jeff-truck/Jan2023-Build/Pics/CPUNanoPCB Board Design.jpg

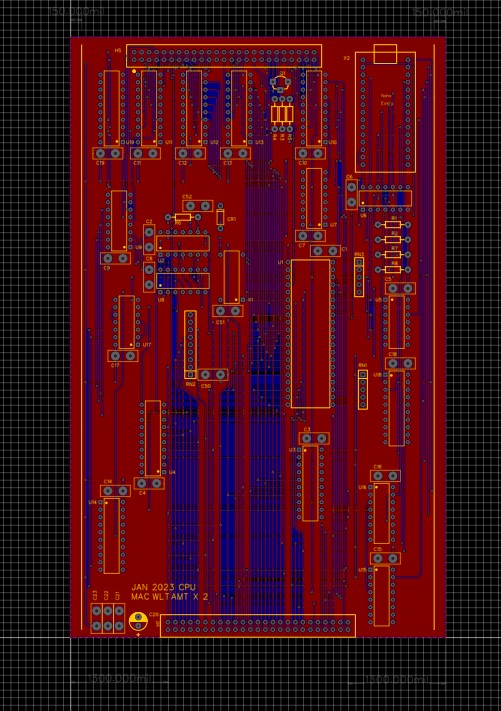
Pics/CPUNanoPCB Board Design.jpg
