jeff-truck/Jan2023-Build/Pics/BackplanePCB Board Design.jpg

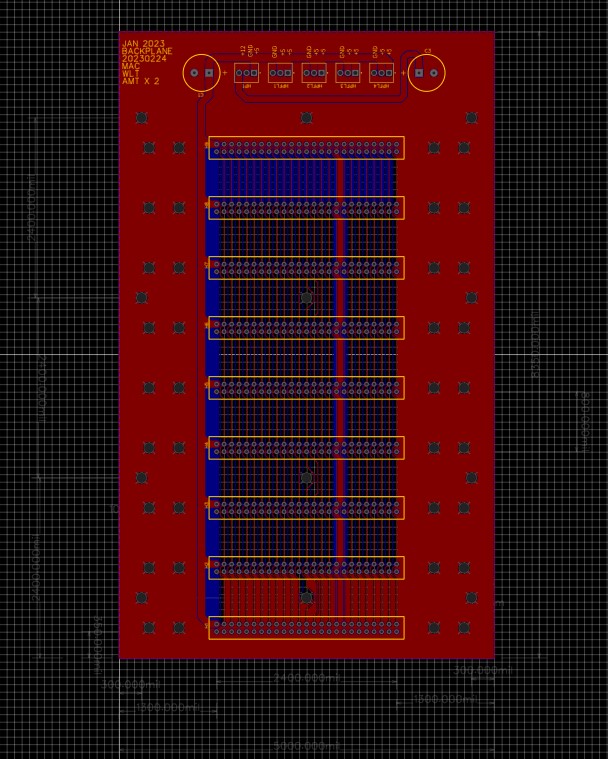
Pics/BackplanePCB Board Design.jpg
