jeff-truck/Jan2023-Build/Pics/DisplayLogicPCB Board Design.jpg

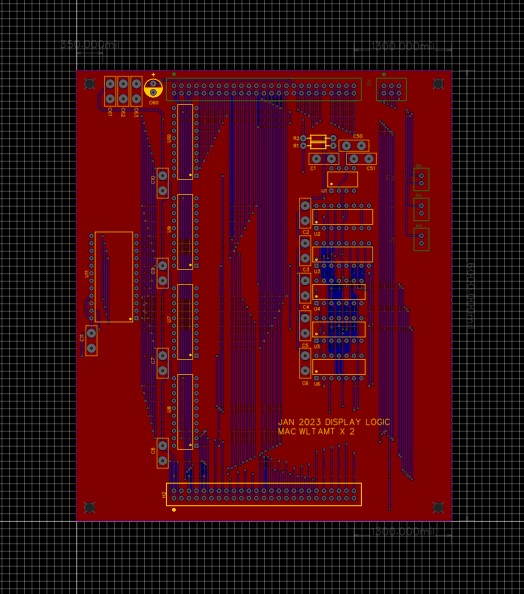
Pics/DisplayLogicPCB Board Design.jpg
