jeff-truck/Jan2023-Build/Pics/DisplayPCB Board Design.jpg

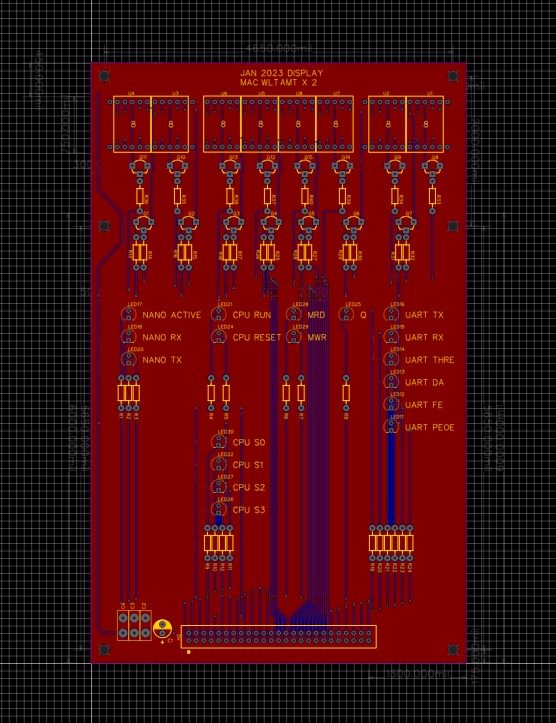
Pics/DisplayPCB Board Design.jpg
