jeff-truck/Jan2023-Build/Pics/IMG_8013.jpg

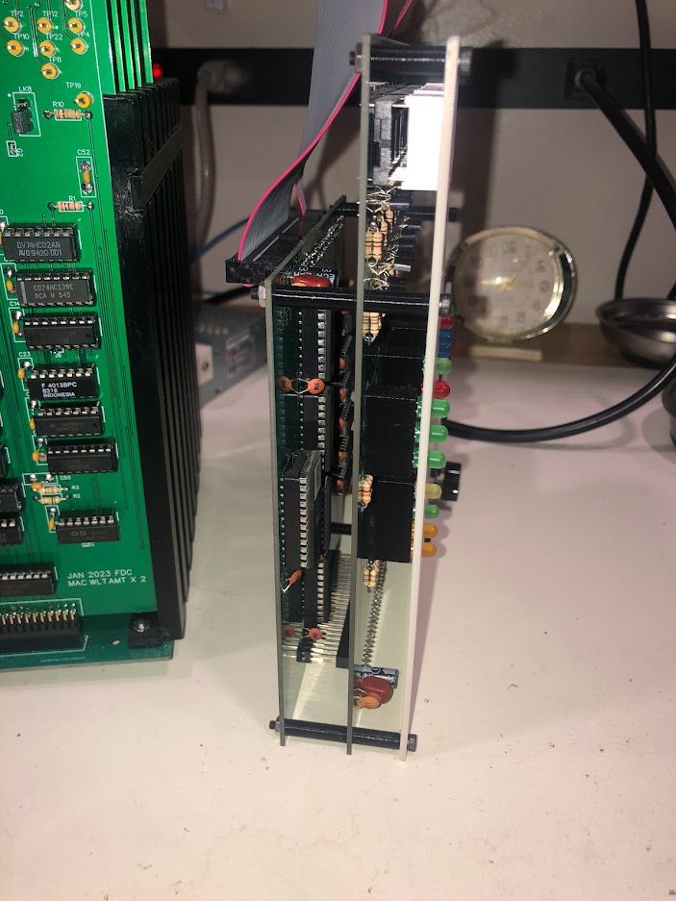
Pics/IMG_8013.jpg
