jeff-truck/Jan2023-Build/Pics/IMG_8014.jpg

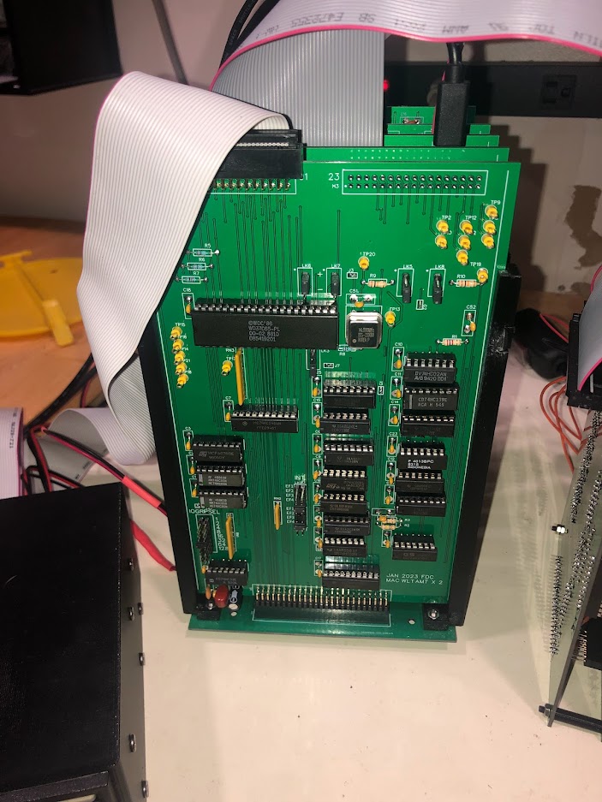
Pics/IMG_8014.jpg
