jeff-truck/Jan2023-Build/Pics/IMG_8015.jpg

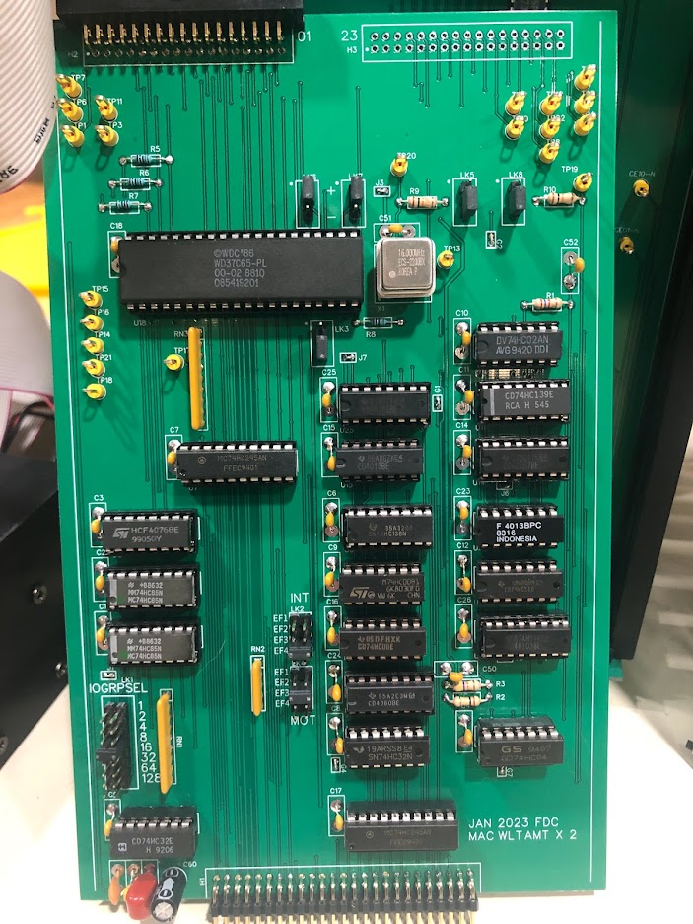
Pics/IMG_8015.jpg
