jeff-truck/Jan2023-Build/Pics/IMG_8016.jpg

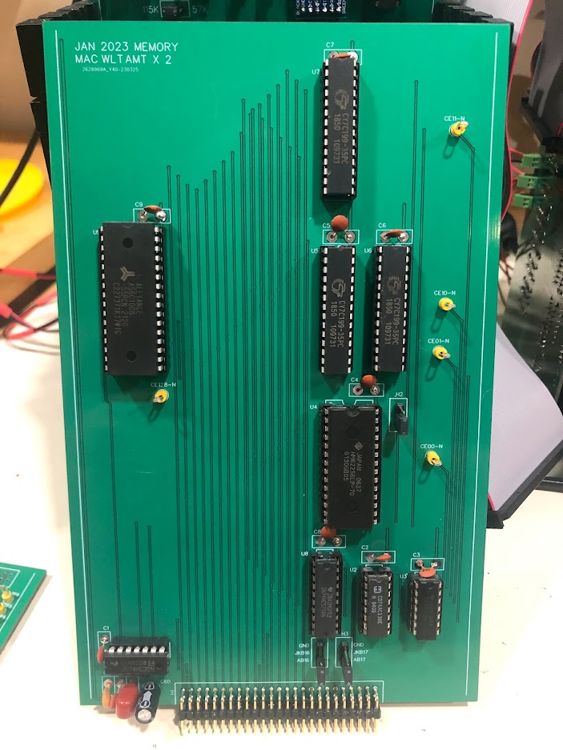
Pics/IMG_8016.jpg
