jeff-truck/Jan2023-Build/Pics/IMG_8017.jpg

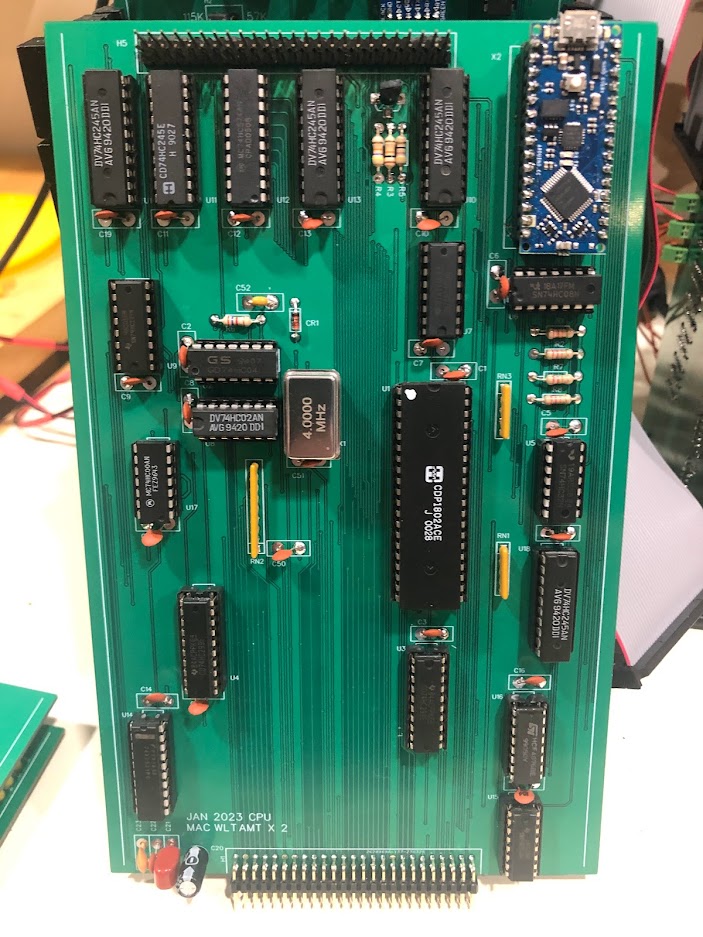
Pics/IMG_8017.jpg
