jeff-truck/Jan2023-Build/Pics/IMG_8018.jpg

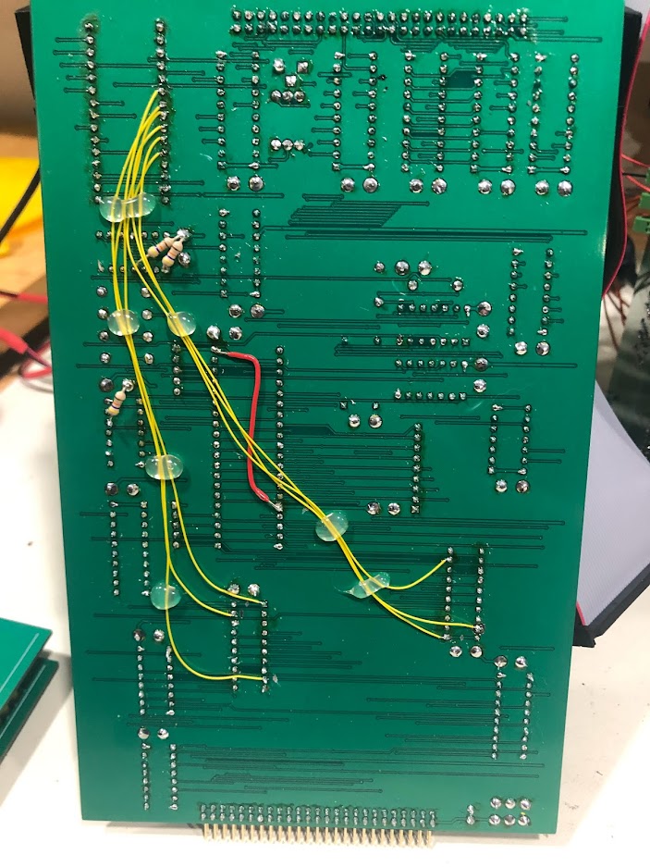
Pics/IMG_8018.jpg
