jeff-truck/Jan2023-Build/Pics/IMG_8019.jpg

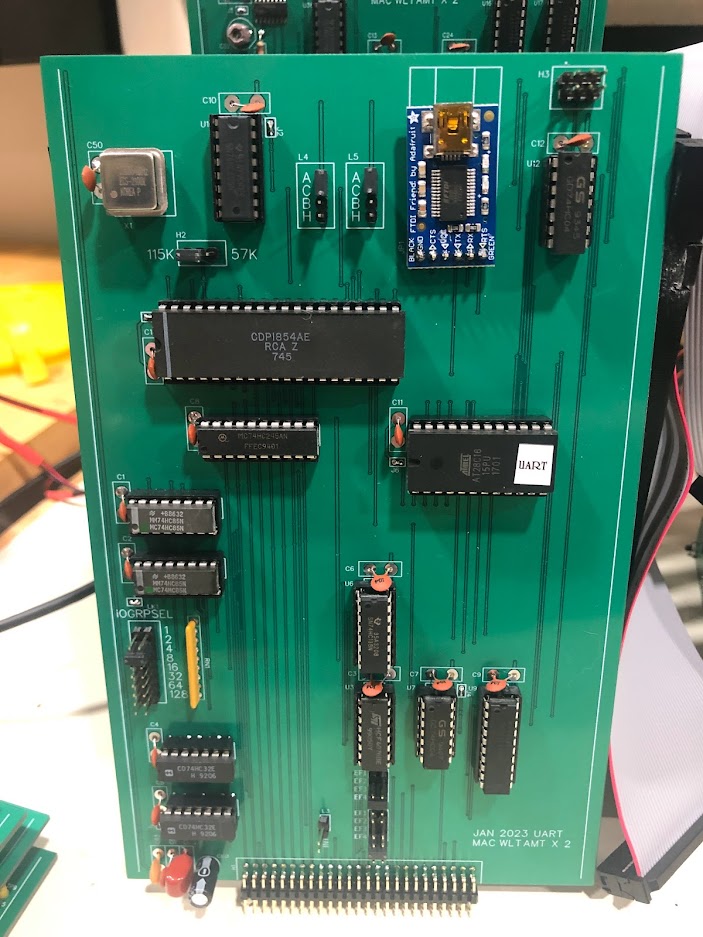
Pics/IMG_8019.jpg
