jeff-truck/Jan2023-Build/Pics/IMG_8020.jpg

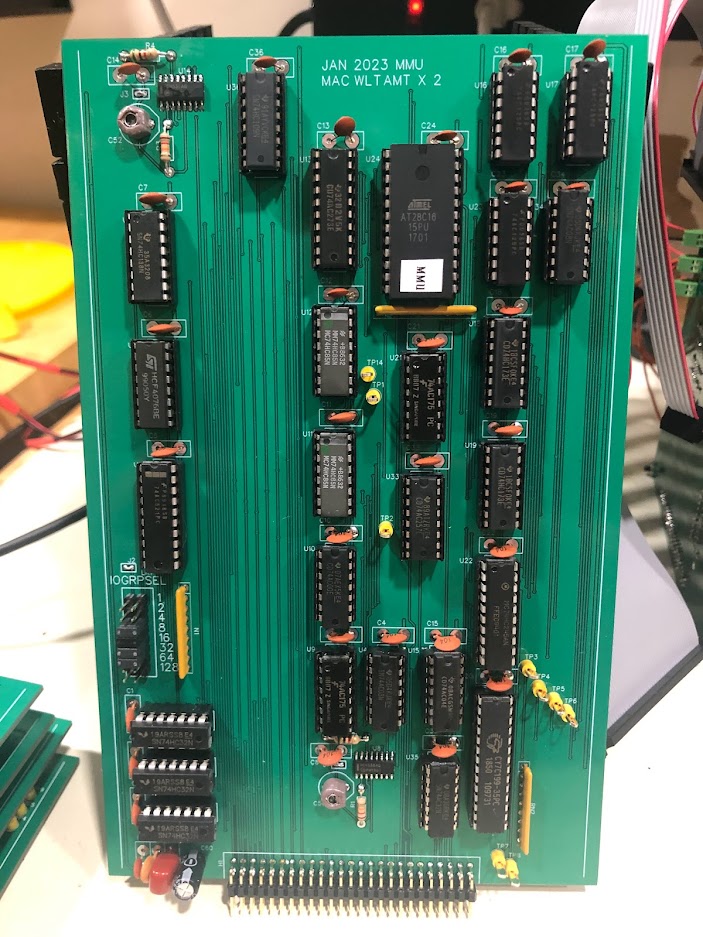
Pics/IMG_8020.jpg
