jeff-truck/Jan2023-Build/Pics/IMG_8021.jpg

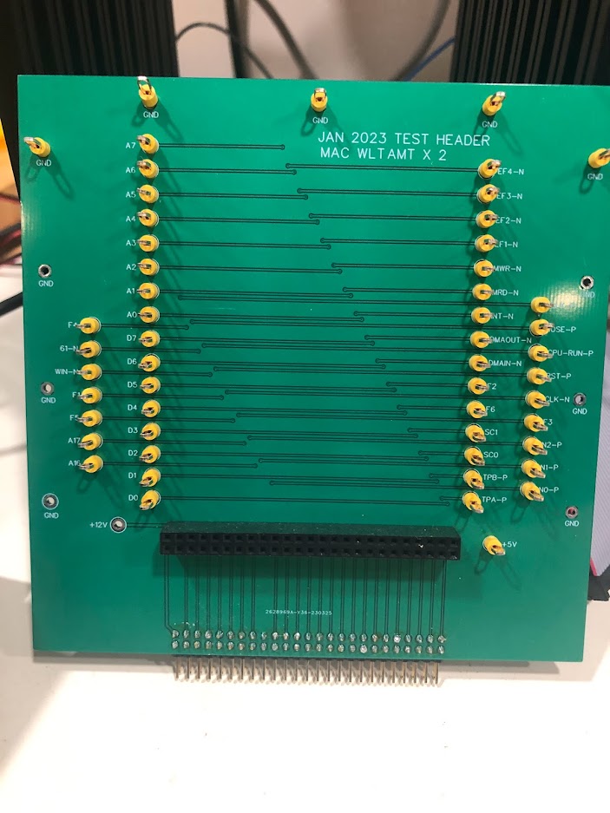
Pics/IMG_8021.jpg
