jeff-truck/Jan2023-Build/Pics/IMG_8023.jpg

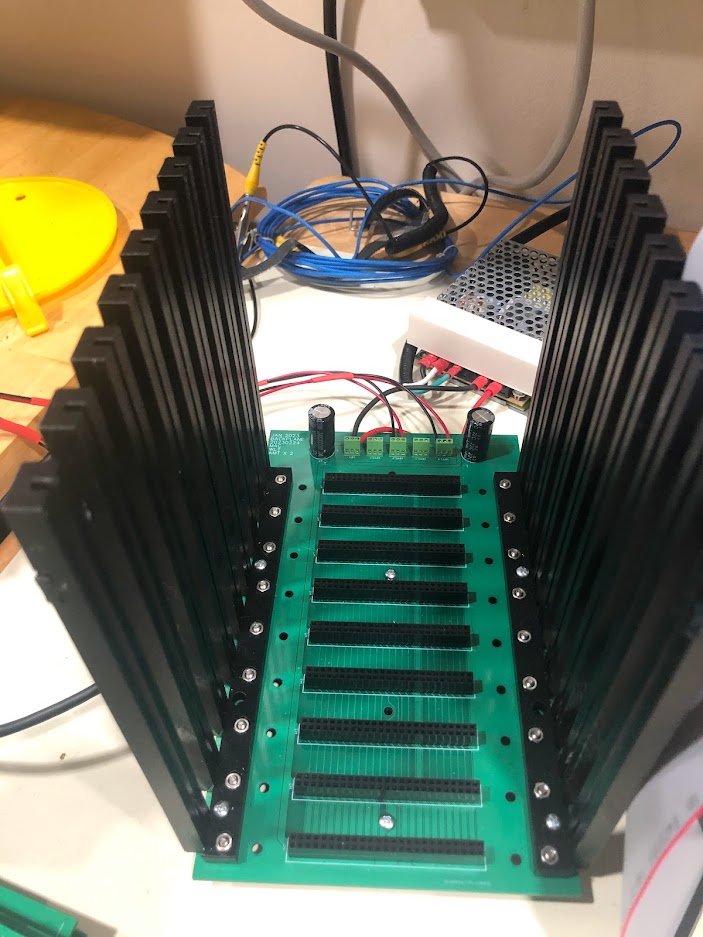
Pics/IMG_8023.jpg
