jeff-truck/Jan2023-Build/Pics/IMG_8024.jpg

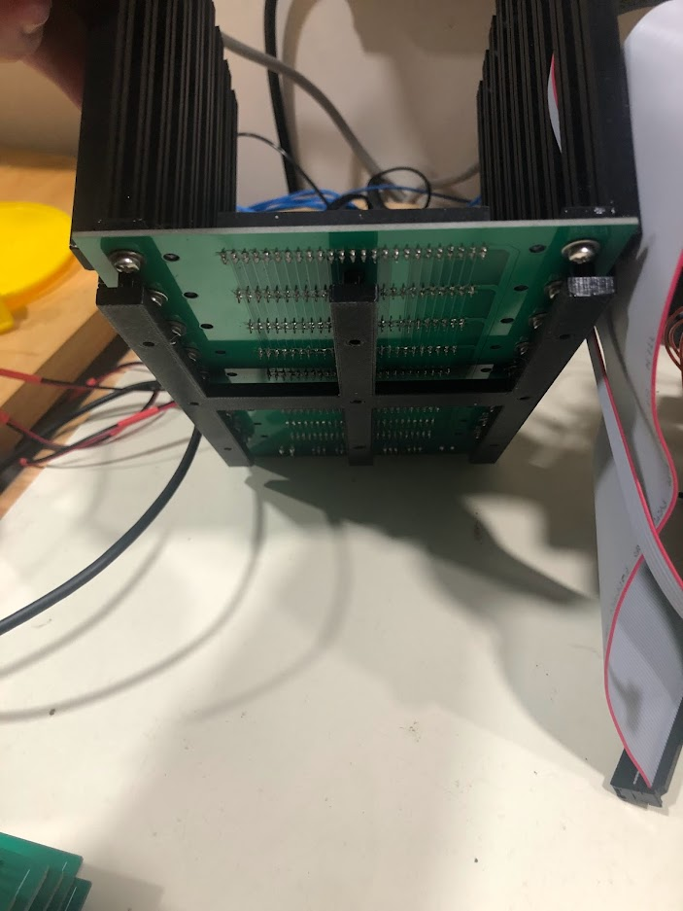
Pics/IMG_8024.jpg
