jeff-truck/Jan2023-Build/Pics/IMG_8026.jpg

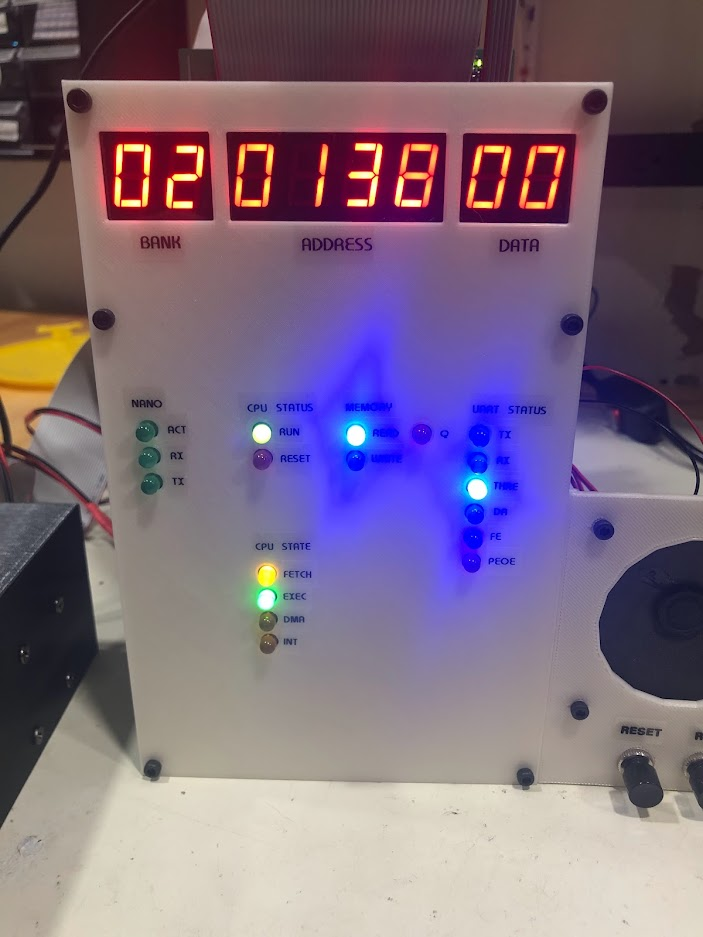
Pics/IMG_8026.jpg
