jeff-truck/Jan2023-Build/Pics/IMG_8030.jpg

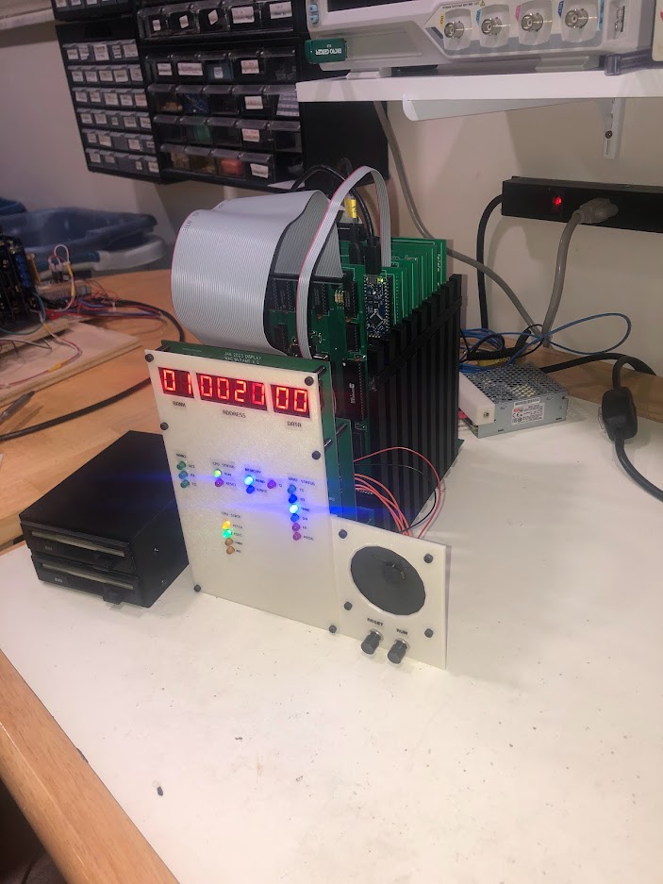
Pics/IMG_8030.jpg
