jeff-truck/Jan2023-Build/Pics/MemoryManagerPCB Board Design.jpg

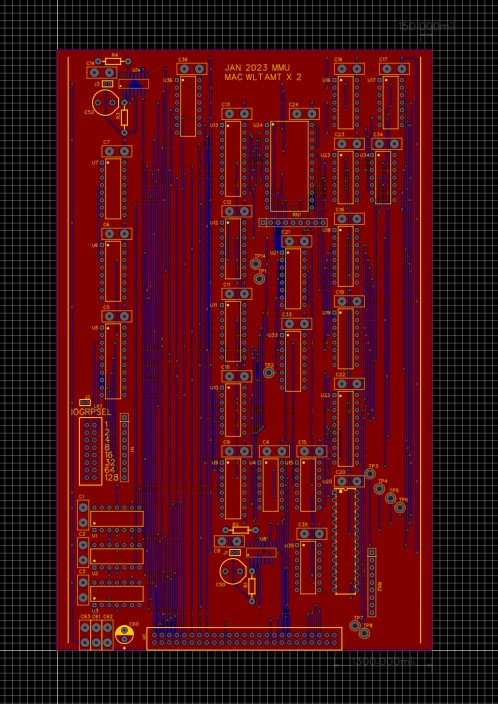
Pics/MemoryManagerPCB Board Design.jpg
