jeff-truck/Jan2023-Build/Pics/MemoryPCB Board Design.jpg

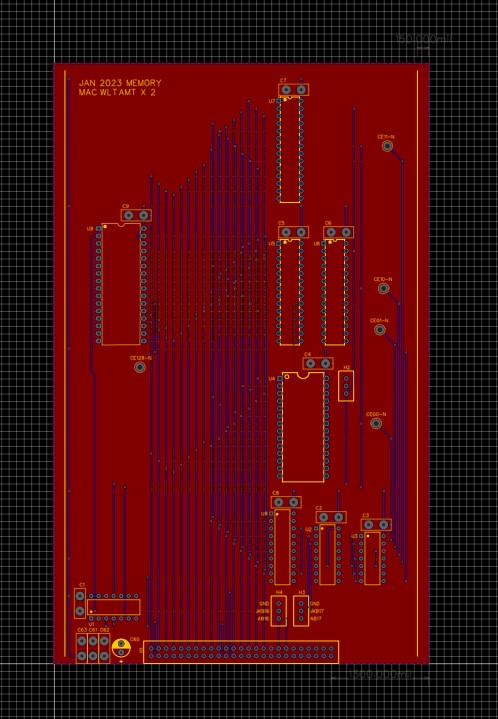
Pics/MemoryPCB Board Design.jpg
