jeff-truck/Jan2023-Build/BOMs/BOM_2023 JAN DISPLAY BOARD_2023-03-24.csv

ID | Name | Designator | Footprint | Quantity
1 | 100uF | C1 | CAP ELEC BOW 3MM LP | 1
2 | CAP 1.0uF LP | C2 | CAP RAD-0.2 LRG PAD | 1
3 | CAP 0.1uF LP | C3 | CAP RAD-0.2 LRG PAD | 1
4 | CAP 0.01uF LP | C4 | CAP RAD-0.2 LRG PAD | 1
5 | 2x25 50P HDR | H2 | 2X25 50P HDR | 1
6 | LED-5MM-RED | LED11,LED12,LED24,LED25 | 5MM LED | 4
7 | LED-5MM-GRN | LED13,LED16,LED17,LED18,LED20,LED21,LED22 | 5MM LED | 7
8 | LED-5MM-BLU | LED14,LED15,LED28,LED29 | 5MM LED | 4
9 | LED-5MM-ORG | LED26,LED27 | 5MM LED | 2
10 | LED-5MM-YLW | LED30 | 5MM LED | 1
11 | 2N2222 JAN 2023 LP | Q1,Q2,Q3,Q4,Q5,Q6,Q7,Q8,Q9,Q10,Q11,Q12,Q13,Q14,Q15 | TO92 LP | 15
12 | 220 RES 0.4 LP | R1,R2,R3,R4,R10,R19,R22 | AXIAL-0.4 LRG PAD | 7
13 | 560 RES 0.4 LP | R5,R8,R23,R24 | AXIAL-0.4 LRG PAD | 4
14 | 680 RES 0.4 LP | R6,R7,R20,R21 | AXIAL-0.4 LRG PAD | 4
15 | 470 RES 0.4 LP | R9,R11,R12 | AXIAL-0.4 LRG PAD | 3
16 | 180 RES 0.4 LP | R13,R16,R18,R26,R28,R29,R31 | AXIAL-0.4 LRG PAD | 7
17 | 1K RES 0.4 LP | R14,R15,R17,R25,R27,R30,R32,R33,R34,R35,R36,R37,R38,R39,R40 | AXIAL-0.4 LRG PAD | 15
18 | 7 SEG CC | U1,U3 | 7 SEG CC 2.54 12.5X15.24 XTRA RIGHT | 2
19 | 7 SEG CC | U2,U4 | 7 SEG CC 2.54 12.5X15.24 XTRA LEFT | 2
20 | 7 SEG CC | U5,U6,U7,U8 | 7 SEG CC 2.54 12.5X15.24 | 4
