jeff-truck/Jan2023-Build/BOMs/BOM_2023 JAN DISPLAY LOGIC_2023-03-24.csv

ID | Name | Designator | Footprint | Quantity
1 | CAP 0.1uF LP | C1,C2,C3,C4,C5,C6,C7,C8,C9,C10,C11,C62 | CAP RAD-0.2 LRG PAD | 12
2 | CAP 0.01uF LP | C50,C51,C63 | CAP RAD-0.2 LRG PAD | 3
3 | 100uF | C60 | CAP ELEC BOW 3MM LP | 1
4 | CAP 1.0uF LP | C61 | CAP RAD-0.2 LRG PAD | 1
5 | 2X25 LINEAR HDR | H1 | 2X25 50P HDR | 1
6 | 2x25 50P HDR | H2 | 2X25 50P HDR | 1
7 | 6 PIN 2X3 HDR | H3 | 2X3 2.54 HDR | 1
8 | 2 PIN GENERAL HDR | H4,H5,H6 | 2 PIN SYSIO HDR | 3
9 | 100K RES 0.4 LP | R1 | AXIAL-0.4 LRG PAD | 1
10 | 1K RES 0.4 LP | R2 | AXIAL-0.4 LRG PAD | 1
11 | 555 | U1 | DIP8 | 1
12 | CD74HCT161 | U2 | DIP16 | 1
13 | CD74HC137 | U3 | DIP16 | 1
14 | CD74HC574 | U7,U8,U9,U10 | DIP20 | 4
15 | AT28C16 | U11 | DIP24-600 | 1
16 | 74HC04 2023 JAN | U4,U5 | DIP14 | 2
17 | 74HC08 JAN 2023 | U6 | DIP14 | 1
