jeff-truck/Jan2023-Build/BOMs/BOM_2023 JAN FDC_2023-05-28.csv

ID | Name | Designator | Footprint | Quantity
1 | CAP 0.1uF LP | C1,C2,C3,C4,C5,C6,C7,C8,C9,C10,C11,C12,C14,C15,C16,C17,C18,C23,C24,C25,C26,C51,C52,C62 | CAP RAD-0.2 LRG PAD | 24
2 | CAP 4700pF LP | C50 | CAP RAD-0.2 LRG PAD | 1
3 | 100uF | C60 | CAP ELEC BOW 3MM LP | 1
4 | CAP 1.0uF LP | C61 | CAP RAD-0.2 LRG PAD | 1
5 | CAP 0.01uF LP | C63 | CAP RAD-0.2 LRG PAD | 1
6 | GNDJMP | G1,G2,G4,G7 | GNDJMP | 4
7 | BRD HEADER 2X25 2023 JAN | H1 | BRD HEADER 2X25 0.100 | 1
8 | FLOPPY HEADER 34PIN | H2,H3 | FLOPPY HEADER 34 PIN | 2
9 | POSJMP | J1,J2,J3,J6,J7 | POSJMP | 5
10 | IO GRP SEL HDR | LK1 | IO GRP SEL HDR | 1
11 | EFx INT-N | LK2 | EFX SELECT LINK | 1
12 | MOTOR FLIP FLOP SOURCE | LK3 | 3 PIN PTH HEADER | 1
13 | EFx MOTOR-ON-N | LK4 | EFX SELECT LINK | 1
14 | IRQ PU PD | LK5 | 3 PIN PTH HEADER | 1
15 | PCVAL SELECT | LK6 | 3 PIN PTH HEADER | 1
16 | DRV SELECT | LK7 | 3 PIN PTH HEADER | 1
17 | DMA PU PD | LK8 | 3 PIN PTH HEADER | 1
18 | 2.7K | R1 | R_AXIAL-0.4 | 1
19 | 100K | R2 | R_AXIAL-0.4 | 1
20 | 47K | R3 | R_AXIAL-0.4 | 1
21 | 150 | R5,R6,R7,R8 | R_AXIAL-0.4 | 4
22 | 10K | R9,R10 | R_AXIAL-0.4 | 2
23 | R_NET_8_10K | RN1,RN3 | R_ARRAY_SIP9 | 2
24 | 4605X 47K 2023 JAN | RN2 | DIP-1X5P-2.54 2023 JAN | 1
25 | 5014 TP | TP1,TP2,TP3,TP4,TP5,TP6,TP7,TP8,TP9,TP10,TP11,TP12,TP13,TP14,TP15,TP16,TP17,TP18,TP19,TP20,TP21,TP22 | 5014 TEST POINT | 22
26 | 74HC85 IO | U1,U2 | DIP16 | 2
27 | 4076 IO | U3 | DIP16 | 1
28 | 74HC138 | U6 | DIP16 | 1
29 | 74HC245 | U7,U17 | DIP20 | 2
30 | 40257 JAN 2023 | U14 | DIP16 | 1
31 | WDC37C65C | U18 | DIP40 | 1
32 | 4060 JAN 2023 | U24 | DIP16 | 1
33 | 40103 | U25,U26 | DIP16 | 2
34 | 16MHZ HC CLK | X1 | HC CLK DIP 8 | 1
35 | 74HC04 2023 JAN | U4 | DIP14 | 1
36 | CD74HC32 JAN 2023 | U5,U8 | DIP14 | 2
37 | 74HC00 JAN 2023 | U9,U16 | DIP14 | 2
38 | 74HC02 JAN 2023 | U10 | DIP14 | 1
39 | 74HC139 JAN 2023 | U11 | DIP16 | 1
40 | 74HC11 JAN 2023 | U12 | DIP14 | 1
41 | 4013 JAN 2023 | U15,U23 | DIP14 | 2
