jeff-truck/Jan2023-Build/BOMs/BOM_2023 JAN MEMORY_2023-03-24.csv

ID | Name | Designator | Footprint | Quantity
1 | CAP 0.1uF LP | C1,C2,C3,C4,C5,C6,C7,C8,C9,C62 | CAP RAD-0.2 LRG PAD | 10
2 | 100uF | C60 | CAP ELEC BOW 3MM LP | 1
3 | CAP 1.0uF LP | C61 | CAP RAD-0.2 LRG PAD | 1
4 | CAP 0.01uF LP | C63 | CAP RAD-0.2 LRG PAD | 1
5 | BRD HEADER 2X25 2023 JAN | H1 | BRD HEADER 2X25 0.100 | 1
6 | 3 PIN PTH HEADER | H2,H3,H4 | 3 PIN PTH HEADER | 3
7 | 5014 TP | TP9,TP10,TP11,TP12,TP13 | 5014 TEST POINT | 5
8 | 74HC32 FULL | U1 | DIP14 | 1
9 | 74AC138 IO | U2 | DIP16 | 1
10 | 74AC08 FULL | U3 | DIP14 | 1
11 | AT28C256 | U4 | PDIP-28_600MIL | 1
12 | CY7C199-35PC | U5,U6,U7 | DIP-28_L35.0-W6.5-P2.54-LS7.6-BL | 3
13 | 74HC573 | U8 | DIP20 | 1
14 | 128K_X_8_RAM | U9 | DIP32_600 | 1
