jeff-truck/Jan2023-Build/BOMs/BOM_2023 JAN UART_2023-03-24.csv

ID | Name | Designator | Footprint | Quantity
1 | CAP 0.1uF LP | C1,C2,C3,C4,C5,C6,C7,C8,C9,C10,C11,C12,C14,C50,C62 | CAP RAD-0.2 LRG PAD | 15
2 | 100uF | C60 | CAP ELEC BOW 3MM LP | 1
3 | CAP 1.0uF LP | C61 | CAP RAD-0.2 LRG PAD | 1
4 | CAP 0.01uF LP | C63 | CAP RAD-0.2 LRG PAD | 1
5 | BRD HEADER 2X25 2023 JAN | H1 | BRD HEADER 2X25 0.100 | 1
6 | 3 PIN GENERAL HDR | H2 | 3 PIN SYSIO HDR | 1
7 | 6 PIN 2X3 HDR | H3 | 2X3 2.54 HDR | 1
8 | POSJMP | J1,J2,J3,J4,J5,J6 | POSJMP | 6
9 | FTDI_DEVICE | JP1 | FTDI FRIEND | 1
10 | EFx Select Link | L1,L2 | EFX SELECT LINK | 2
11 | INT Enable Link | L3 | INT SELECT LINK | 1
12 | UART EXT ES LINK | L4 | UART EXT ES | 1
13 | UART EXT PSI LINK | L5 | UART EXT ES | 1
14 | IO GRP SEL HDR | LK1 | IO GRP SEL HDR | 1
15 | R_NET_8_10K | RN1 | R_ARRAY_SIP9 | 1
16 | 74HC85 IO | U1,U2 | DIP16 | 2
17 | 4076 IO | U3 | DIP16 | 1
18 | 74HC138 | U6 | DIP16 | 1
19 | 74HC245 | U8,U9 | DIP20 | 2
20 | AT28C16 IO | U11 | DIP24-600 | 1
21 | CDP 1854 | U14 | CDP 1854 | 1
22 | ECS-2100X 3.6864MHz | X1 | ECS-2100X 3.6864MHZ | 1
23 | CD74HC32 JAN 2023 | U4,U5 | DIP14 | 2
24 | 74HC04 2023 JAN | U7,U12 | DIP14 | 2
25 | 74HC109 JAN 2023 | U10 | DIP16 | 1
