jeff-truck/Jan2023-Build/BOMs/BOM_2023 JAN CPU V1_2023-03-24.csv

ID | Name | Designator | Footprint | Quantity
1 | CAP 0.1uF LP | C1,C2,C3,C4,C5,C6,C7,C8,C9,C10,C11,C12,C13,C14,C15,C16,C17,C18,C19,C22,C50,C51 | CAP RAD-0.2 LRG PAD | 22
2 | 100uF | C20 | CAP ELEC BOW 3MM LP | 1
3 | CAP 1.0uF LP | C21 | CAP RAD-0.2 LRG PAD | 1
4 | CAP 0.01uF LP | C23 | CAP RAD-0.2 LRG PAD | 1
5 | CAP 47pF LP | C52 | CAP RAD-0.2 LRG PAD | 1
6 | 1N914 | CR1 | DO-35 | 1
7 | BRD HEADER 2X25 2023 JAN | H1 | BRD HEADER 2X25 0.100 | 1
8 | 2X25 LINEAR HDR | H5 | 2X25 50P HDR | 1
9 | 2N2222 JAN 2023 LP | Q1 | TO92 LP | 1
10 | 22K RES 0.4 LP | R1,R2,R7,R8 | AXIAL-0.4 LRG PAD | 4
11 | 10K RES 0.4 LP | R3 | AXIAL-0.4 LRG PAD | 1
12 | 47K RES 0.4 LP | R4 | AXIAL-0.4 LRG PAD | 1
13 | 100 RES 0.4 LP | R5 | AXIAL-0.4 LRG PAD | 1
14 | 2.7K RES 0.4 LP | R6 | AXIAL-0.4 LRG PAD | 1
15 | 4605X 47K 2023 JAN | RN1,RN3 | DIP-1X5P-2.54 2023 JAN | 2
16 | 4609X 22K 2023 JAN | RN2 | DIP-1X9P-2.54 2023 JAN | 1
17 | CDP 1802 2023 JAN | U1 | CDP 1802 | 1
18 | 74HC299 IO | U3,U4 | DIP20 | 2
19 | 74HC245 | U10,U11,U13,U18,U19 | DIP20 | 5
20 | CD74HC574 | U12 | DIP20 | 1
21 | 74AC521 IO | U14 | DIP20 | 1
22 | CD74HC138E | U15 | DIP16 | 1
23 | 4076 | U16 | DIP16 | 1
24 | 4MHZ CMOS CLK CAN | X1 | 4MHZ CMOS CLK CAN | 1
25 | NANO EVERY JAN 2023 | X2 | NANOEVERY JAN 2023 | 1
26 | 74HC04 2023 JAN | U2 | DIP14 | 1
27 | CD74HC32 JAN 2023 | U5 | DIP14 | 1
28 | 74HC08 JAN 2023 | U6 | DIP14 | 1
29 | 74HC109 JAN 2023 | U7 | DIP16 | 1
30 | 74HC02 JAN 2023 | U8 | DIP14 | 1
31 | 74HC139 JAN 2023 | U9 | DIP16 | 1
32 | 74HC00 JAN 2023 | U17 | DIP14 | 1
