jeff-truck/Jan2023-Build/BOMs/BOM_2023 JAN MMU_2023-03-24.csv

ID | Name | Designator | Footprint | Quantity
1 | CAP 0.1uF LP | C1,C2,C3,C4,C5,C6,C7,C8,C9,C10,C11,C12,C13,C14,C15,C16,C17,C18,C19,C20,C21,C22,C23,C24,C33,C34,C35,C36,C62 | CAP RAD-0.2 LRG PAD | 29
2 | CAP-ADJ 12-60PF | C50,C52 | GKGXX015 | 2
3 | 100uF | C60 | CAP ELEC BOW 3MM LP | 1
4 | CAP 1.0uF LP | C61 | CAP RAD-0.2 LRG PAD | 1
5 | CAP 0.01uF LP | C63 | CAP RAD-0.2 LRG PAD | 1
6 | BRD HEADER 2X25 2023 JAN | H1 | BRD HEADER 2X25 0.100 | 1
7 | POSJMP | J1,J2,J3 | POSJMP | 3
8 | IO GRP SEL HDR | LK1 | IO GRP SEL HDR | 1
9 | 8 PIN 10K | N1 | R_ARRAY_SIP9 | 1
10 | 12K RES 0.4 LP | R1,R3 | AXIAL-0.4 LRG PAD | 2
11 | 5.1K RES 0.4 LP | R2,R4 | AXIAL-0.4 LRG PAD | 2
12 | R_NET_8_10K | RN1 | R_ARRAY_SIP9 | 1
13 | R_NET_8_22K | RN2 | R_ARRAY_SIP9 | 1
14 | 5014 TP | TP1,TP2,TP3,TP4,TP5,TP6,TP7,TP8,TP14 | 5014 TEST POINT | 9
15 | 74HC32 FULL | U1,U2,U3 | DIP14 | 3
16 | 74AC521 IO | U5 | DIP20 | 1
17 | 4076 | U6 | DIP16 | 1
18 | CD74HC138E | U7 | DIP16 | 1
19 | 74HC4538ADR | U8,U14 | SOIC-16_L9.9-W3.9-P1.27-LS6.0-BL | 2
20 | 74AC175 IO | U9,U21 | DIP16 | 2
21 | 74HC85 IO | U11,U12 | DIP16 | 2
22 | 74AC273 IO | U13 | DIP20 | 1
23 | 74AC125 IO | U16,U17,U23 | DIP14 | 3
24 | 74HC173 IO | U18,U19 | DIP16 | 2
25 | CY7C199-35PC | U20 | DIP-28_L35.0-W6.5-P2.54-LS7.6-BL | 1
26 | 74HC245 | U22 | DIP20 | 1
27 | AT28C16 IO | U24 | DIP24-600 | 1
28 | CD74AC257 IO | U33 | DIP16 | 1
29 | 74AC08 JAN 2023 | U4,U34 | DIP14 | 2
30 | 74AC00 JAN 2023 | U10 | DIP14 | 1
31 | 74AC04 | U15 | DIP14 | 1
32 | 74AC32 JAN 2023 | U35 | DIP14 | 1
33 | 74HC109 JAN 2023 | U36 | DIP16 | 1
