jeff-truck/Jan2023-Build/Microcode/1802 Instruction Set Microcode 20221230.xlsx

 |  |  |  |  |  |  |  |  |  | FETCHED INSTRUCTION |  |  |  |  |  |  |  | INDEX |  |  |  | N | X | P
FAMILY | GROUP | MNEMONIC | OP CODE | OPERATION | I | N | X BASED | MEM ACC | REG BANK | A0 | A1 | A2 | A3 | A4 | A5 | A6 | A7 | D0 | D1 | D2 | D3 | D4 | D5 | D6
MEMORY REFERENCE | 3: R/R | LDN | 01 | M(R(N)) → D; FOR N not 0 | 0 | 1 | N | Y | 1 | 1 | 0 | 0 | 0 | 0 | 0 | 0 | 0 | 1 | 0 | 0 | 0 | 0 | 1 | 1 | 1 => '61',
MEMORY REFERENCE | 3: R/R | LDN | 02 | M(R(N)) → D; FOR N not 0 | 0 | 2 | N | Y | 2 | 0 | 1 | 0 | 0 | 0 | 0 | 0 | 0 | 0 | 1 | 0 | 0 | 0 | 1 | 1 | 2 => '62',
MEMORY REFERENCE | 3: R/R | LDN | 03 | M(R(N)) → D; FOR N not 0 | 0 | 3 | N | Y | 3 | 1 | 1 | 0 | 0 | 0 | 0 | 0 | 0 | 1 | 1 | 0 | 0 | 0 | 1 | 1 | 3 => '63',
MEMORY REFERENCE | 3: R/R | LDN | 04 | M(R(N)) → D; FOR N not 0 | 0 | 4 | N | Y | 4 | 0 | 0 | 1 | 0 | 0 | 0 | 0 | 0 | 0 | 0 | 1 | 0 | 0 | 1 | 1 | 4 => '64',
MEMORY REFERENCE | 3: R/R | LDN | 05 | M(R(N)) → D; FOR N not 0 | 0 | 5 | N | Y | 5 | 1 | 0 | 1 | 0 | 0 | 0 | 0 | 0 | 1 | 0 | 1 | 0 | 0 | 1 | 1 | 5 => '65',
MEMORY REFERENCE | 3: R/R | LDN | 06 | M(R(N)) → D; FOR N not 0 | 0 | 6 | N | Y | 6 | 0 | 1 | 1 | 0 | 0 | 0 | 0 | 0 | 0 | 1 | 1 | 0 | 0 | 1 | 1 | 6 => '66',
MEMORY REFERENCE | 3: R/R | LDN | 07 | M(R(N)) → D; FOR N not 0 | 0 | 7 | N | Y | 7 | 1 | 1 | 1 | 0 | 0 | 0 | 0 | 0 | 1 | 1 | 1 | 0 | 0 | 1 | 1 | 7 => '67',
MEMORY REFERENCE | 3: R/R | LDN | 08 | M(R(N)) → D; FOR N not 0 | 0 | 8 | N | Y | 8 | 0 | 0 | 0 | 1 | 0 | 0 | 0 | 0 | 0 | 0 | 0 | 1 | 0 | 1 | 1 | 8 => '68',
MEMORY REFERENCE | 3: R/R | LDN | 09 | M(R(N)) → D; FOR N not 0 | 0 | 9 | N | Y | 9 | 1 | 0 | 0 | 1 | 0 | 0 | 0 | 0 | 1 | 0 | 0 | 1 | 0 | 1 | 1 | 9 => '69',
MEMORY REFERENCE | 3: R/R | LDN | 0A | M(R(N)) → D; FOR N not 0 | 0 | A | N | Y | A | 0 | 1 | 0 | 1 | 0 | 0 | 0 | 0 | 0 | 1 | 0 | 1 | 0 | 1 | 1 | 10 => '6A',
MEMORY REFERENCE | 3: R/R | LDN | 0B | M(R(N)) → D; FOR N not 0 | 0 | B | N | Y | B | 1 | 1 | 0 | 1 | 0 | 0 | 0 | 0 | 1 | 1 | 0 | 1 | 0 | 1 | 1 | 11 => '6B',
MEMORY REFERENCE | 3: R/R | LDN | 0C | M(R(N)) → D; FOR N not 0 | 0 | C | N | Y | C | 0 | 0 | 1 | 1 | 0 | 0 | 0 | 0 | 0 | 0 | 1 | 1 | 0 | 1 | 1 | 12 => '6C',
MEMORY REFERENCE | 3: R/R | LDN | 0D | M(R(N)) → D; FOR N not 0 | 0 | D | N | Y | D | 1 | 0 | 1 | 1 | 0 | 0 | 0 | 0 | 1 | 0 | 1 | 1 | 0 | 1 | 1 | 13 => '6D',
MEMORY REFERENCE | 3: R/R | LDN | 0E | M(R(N)) → D; FOR N not 0 | 0 | E | N | Y | E | 0 | 1 | 1 | 1 | 0 | 0 | 0 | 0 | 0 | 1 | 1 | 1 | 0 | 1 | 1 | 14 => '6E',
MEMORY REFERENCE | 3: R/R | LDN | 0F | M(R(N)) → D; FOR N not 0 | 0 | F | N | Y | F | 1 | 1 | 1 | 1 | 0 | 0 | 0 | 0 | 1 | 1 | 1 | 1 | 0 | 1 | 1 | 15 => '6F',
MEMORY REFERENCE | 3: R/R | LDA | 40 | M(R(N)) → D; R(N) + 1 → R(N) | 4 | 0 | N | Y | 0 | 0 | 0 | 0 | 0 | 0 | 0 | 1 | 0 | 0 | 0 | 0 | 0 | 0 | 1 | 1 | 64 => '60',
MEMORY REFERENCE | 3: R/R | LDA | 41 | M(R(N)) → D; R(N) + 1 → R(N) | 4 | 1 | N | Y | 1 | 1 | 0 | 0 | 0 | 0 | 0 | 1 | 0 | 1 | 0 | 0 | 0 | 0 | 1 | 1 | 65 => '61',
MEMORY REFERENCE | 3: R/R | LDA | 42 | M(R(N)) → D; R(N) + 1 → R(N) | 4 | 2 | N | Y | 2 | 0 | 1 | 0 | 0 | 0 | 0 | 1 | 0 | 0 | 1 | 0 | 0 | 0 | 1 | 1 | 66 => '62',
MEMORY REFERENCE | 3: R/R | LDA | 43 | M(R(N)) → D; R(N) + 1 → R(N) | 4 | 3 | N | Y | 3 | 1 | 1 | 0 | 0 | 0 | 0 | 1 | 0 | 1 | 1 | 0 | 0 | 0 | 1 | 1 | 67 => '63',
MEMORY REFERENCE | 3: R/R | LDA | 44 | M(R(N)) → D; R(N) + 1 → R(N) | 4 | 4 | N | Y | 4 | 0 | 0 | 1 | 0 | 0 | 0 | 1 | 0 | 0 | 0 | 1 | 0 | 0 | 1 | 1 | 68 => '64',
MEMORY REFERENCE | 3: R/R | LDA | 45 | M(R(N)) → D; R(N) + 1 → R(N) | 4 | 5 | N | Y | 5 | 1 | 0 | 1 | 0 | 0 | 0 | 1 | 0 | 1 | 0 | 1 | 0 | 0 | 1 | 1 | 69 => '65',
MEMORY REFERENCE | 3: R/R | LDA | 46 | M(R(N)) → D; R(N) + 1 → R(N) | 4 | 6 | N | Y | 6 | 0 | 1 | 1 | 0 | 0 | 0 | 1 | 0 | 0 | 1 | 1 | 0 | 0 | 1 | 1 | 70 => '66',
MEMORY REFERENCE | 3: R/R | LDA | 47 | M(R(N)) → D; R(N) + 1 → R(N) | 4 | 7 | N | Y | 7 | 1 | 1 | 1 | 0 | 0 | 0 | 1 | 0 | 1 | 1 | 1 | 0 | 0 | 1 | 1 | 71 => '67',
MEMORY REFERENCE | 3: R/R | LDA | 48 | M(R(N)) → D; R(N) + 1 → R(N) | 4 | 8 | N | Y | 8 | 0 | 0 | 0 | 1 | 0 | 0 | 1 | 0 | 0 | 0 | 0 | 1 | 0 | 1 | 1 | 72 => '68',
MEMORY REFERENCE | 3: R/R | LDA | 49 | M(R(N)) → D; R(N) + 1 → R(N) | 4 | 9 | N | Y | 9 | 1 | 0 | 0 | 1 | 0 | 0 | 1 | 0 | 1 | 0 | 0 | 1 | 0 | 1 | 1 | 73 => '69',
MEMORY REFERENCE | 3: R/R | LDA | 4A | M(R(N)) → D; R(N) + 1 → R(N) | 4 | A | N | Y | A | 0 | 1 | 0 | 1 | 0 | 0 | 1 | 0 | 0 | 1 | 0 | 1 | 0 | 1 | 1 | 74 => '6A',
MEMORY REFERENCE | 3: R/R | LDA | 4B | M(R(N)) → D; R(N) + 1 → R(N) | 4 | B | N | Y | B | 1 | 1 | 0 | 1 | 0 | 0 | 1 | 0 | 1 | 1 | 0 | 1 | 0 | 1 | 1 | 75 => '6B',
MEMORY REFERENCE | 3: R/R | LDA | 4C | M(R(N)) → D; R(N) + 1 → R(N) | 4 | C | N | Y | C | 0 | 0 | 1 | 1 | 0 | 0 | 1 | 0 | 0 | 0 | 1 | 1 | 0 | 1 | 1 | 76 => '6C',
MEMORY REFERENCE | 3: R/R | LDA | 4D | M(R(N)) → D; R(N) + 1 → R(N) | 4 | D | N | Y | D | 1 | 0 | 1 | 1 | 0 | 0 | 1 | 0 | 1 | 0 | 1 | 1 | 0 | 1 | 1 | 77 => '6D',
MEMORY REFERENCE | 3: R/R | LDA | 4E | M(R(N)) → D; R(N) + 1 → R(N) | 4 | E | N | Y | E | 0 | 1 | 1 | 1 | 0 | 0 | 1 | 0 | 0 | 1 | 1 | 1 | 0 | 1 | 1 | 78 => '6E',
MEMORY REFERENCE | 3: R/R | LDA | 4F | M(R(N)) → D; R(N) + 1 → R(N) | 4 | F | N | Y | F | 1 | 1 | 1 | 1 | 0 | 0 | 1 | 0 | 1 | 1 | 1 | 1 | 0 | 1 | 1 | 79 => '6F',
MEMORY REFERENCE | 3: R/R | LDX | F0 | M(R(X)) → D | F | 0 | Y | Y | X | 0 | 0 | 0 | 0 | 1 | 1 | 1 | 1 | 0 | 0 | 0 | 0 | 1 | 0 | 1 | 240 => '50',
MEMORY REFERENCE | 3: R/R | LDXA | 72 | M(R(X)) → D; R(X) + 1 → R(X) | 7 | 2 | Y | Y | X | 0 | 1 | 0 | 0 | 1 | 1 | 1 | 0 | 0 | 0 | 0 | 0 | 1 | 0 | 1 | 114 => '50',
MEMORY REFERENCE | 3: R/R | LDI | F8 | M(R(P)) → D; R(P) + 1 → R(P) | F | 8 | N | Y | P | 0 | 0 | 0 | 1 | 1 | 1 | 1 | 1 | 0 | 0 | 0 | 0 | 1 | 1 | 0 | 248 => '30',
MEMORY REFERENCE | 2: R/W | STR | 50 | D → M(R(N)) | 5 | 0 | N | Y | 0 | 0 | 0 | 0 | 0 | 1 | 0 | 1 | 0 | 0 | 0 | 0 | 0 | 0 | 1 | 1 | 80 => '60',
MEMORY REFERENCE | 2: R/W | STR | 51 | D → M(R(N)) | 5 | 1 | N | Y | 1 | 1 | 0 | 0 | 0 | 1 | 0 | 1 | 0 | 1 | 0 | 0 | 0 | 0 | 1 | 1 | 81 => '61',
MEMORY REFERENCE | 2: R/W | STR | 52 | D → M(R(N)) | 5 | 2 | N | Y | 2 | 0 | 1 | 0 | 0 | 1 | 0 | 1 | 0 | 0 | 1 | 0 | 0 | 0 | 1 | 1 | 82 => '62',
MEMORY REFERENCE | 2: R/W | STR | 53 | D → M(R(N)) | 5 | 3 | N | Y | 3 | 1 | 1 | 0 | 0 | 1 | 0 | 1 | 0 | 1 | 1 | 0 | 0 | 0 | 1 | 1 | 83 => '63',
MEMORY REFERENCE | 2: R/W | STR | 54 | D → M(R(N)) | 5 | 4 | N | Y | 4 | 0 | 0 | 1 | 0 | 1 | 0 | 1 | 0 | 0 | 0 | 1 | 0 | 0 | 1 | 1 | 84 => '64',
MEMORY REFERENCE | 2: R/W | STR | 55 | D → M(R(N)) | 5 | 5 | N | Y | 5 | 1 | 0 | 1 | 0 | 1 | 0 | 1 | 0 | 1 | 0 | 1 | 0 | 0 | 1 | 1 | 85 => '65',
MEMORY REFERENCE | 2: R/W | STR | 56 | D → M(R(N)) | 5 | 6 | N | Y | 6 | 0 | 1 | 1 | 0 | 1 | 0 | 1 | 0 | 0 | 1 | 1 | 0 | 0 | 1 | 1 | 86 => '66',
MEMORY REFERENCE | 2: R/W | STR | 57 | D → M(R(N)) | 5 | 7 | N | Y | 7 | 1 | 1 | 1 | 0 | 1 | 0 | 1 | 0 | 1 | 1 | 1 | 0 | 0 | 1 | 1 | 87 => '67',
MEMORY REFERENCE | 2: R/W | STR | 58 | D → M(R(N)) | 5 | 8 | N | Y | 8 | 0 | 0 | 0 | 1 | 1 | 0 | 1 | 0 | 0 | 0 | 0 | 1 | 0 | 1 | 1 | 88 => '68',
MEMORY REFERENCE | 2: R/W | STR | 59 | D → M(R(N)) | 5 | 9 | N | Y | 9 | 1 | 0 | 0 | 1 | 1 | 0 | 1 | 0 | 1 | 0 | 0 | 1 | 0 | 1 | 1 | 89 => '69',
MEMORY REFERENCE | 2: R/W | STR | 5A | D → M(R(N)) | 5 | A | N | Y | A | 0 | 1 | 0 | 1 | 1 | 0 | 1 | 0 | 0 | 1 | 0 | 1 | 0 | 1 | 1 | 90 => '6A',
MEMORY REFERENCE | 2: R/W | STR | 5B | D → M(R(N)) | 5 | B | N | Y | B | 1 | 1 | 0 | 1 | 1 | 0 | 1 | 0 | 1 | 1 | 0 | 1 | 0 | 1 | 1 | 91 => '6B',
MEMORY REFERENCE | 2: R/W | STR | 5C | D → M(R(N)) | 5 | C | N | Y | C | 0 | 0 | 1 | 1 | 1 | 0 | 1 | 0 | 0 | 0 | 1 | 1 | 0 | 1 | 1 | 92 => '6C',
MEMORY REFERENCE | 2: R/W | STR | 5D | D → M(R(N)) | 5 | D | N | Y | D | 1 | 0 | 1 | 1 | 1 | 0 | 1 | 0 | 1 | 0 | 1 | 1 | 0 | 1 | 1 | 93 => '6D',
MEMORY REFERENCE | 2: R/W | STR | 5E | D → M(R(N)) | 5 | E | N | Y | E | 0 | 1 | 1 | 1 | 1 | 0 | 1 | 0 | 0 | 1 | 1 | 1 | 0 | 1 | 1 | 94 => '6E',
MEMORY REFERENCE | 2: R/W | STR | 5F | D → M(R(N)) | 5 | F | N | Y | F | 1 | 1 | 1 | 1 | 1 | 0 | 1 | 0 | 1 | 1 | 1 | 1 | 0 | 1 | 1 | 95 => '6F',
MEMORY REFERENCE | 2: R/W | STXD | 73 | D → M(R(X)); R(X) - 1 → R(X) | 7 | 3 | Y | Y | X | 1 | 1 | 0 | 0 | 1 | 1 | 1 | 0 | 0 | 0 | 0 | 0 | 1 | 0 | 1 | 115 => '50',
REGISTER OPERATIONS | 1: R/NM | INC | 10 | R(N) + 1 → R(N) | 1 | 0 | N | N |  | 0 | 0 | 0 | 0 | 1 | 0 | 0 | 0 | 0 | 0 | 0 | 0 | 1 | 1 | 0 | 16 => '30',
REGISTER OPERATIONS | 1: R/NM | INC | 11 | R(N) + 1 → R(N) | 1 | 1 | N | N |  | 1 | 0 | 0 | 0 | 1 | 0 | 0 | 0 | 0 | 0 | 0 | 0 | 1 | 1 | 0 | 17 => '30',
REGISTER OPERATIONS | 1: R/NM | INC | 12 | R(N) + 1 → R(N) | 1 | 2 | N | N |  | 0 | 1 | 0 | 0 | 1 | 0 | 0 | 0 | 0 | 0 | 0 | 0 | 1 | 1 | 0 | 18 => '30',
REGISTER OPERATIONS | 1: R/NM | INC | 13 | R(N) + 1 → R(N) | 1 | 3 | N | N |  | 1 | 1 | 0 | 0 | 1 | 0 | 0 | 0 | 0 | 0 | 0 | 0 | 1 | 1 | 0 | 19 => '30',
REGISTER OPERATIONS | 1: R/NM | INC | 14 | R(N) + 1 → R(N) | 1 | 4 | N | N |  | 0 | 0 | 1 | 0 | 1 | 0 | 0 | 0 | 0 | 0 | 0 | 0 | 1 | 1 | 0 | 20 => '30',
REGISTER OPERATIONS | 1: R/NM | INC | 15 | R(N) + 1 → R(N) | 1 | 5 | N | N |  | 1 | 0 | 1 | 0 | 1 | 0 | 0 | 0 | 0 | 0 | 0 | 0 | 1 | 1 | 0 | 21 => '30',
REGISTER OPERATIONS | 1: R/NM | INC | 16 | R(N) + 1 → R(N) | 1 | 6 | N | N |  | 0 | 1 | 1 | 0 | 1 | 0 | 0 | 0 | 0 | 0 | 0 | 0 | 1 | 1 | 0 | 22 => '30',
REGISTER OPERATIONS | 1: R/NM | INC | 17 | R(N) + 1 → R(N) | 1 | 7 | N | N |  | 1 | 1 | 1 | 0 | 1 | 0 | 0 | 0 | 0 | 0 | 0 | 0 | 1 | 1 | 0 | 23 => '30',
REGISTER OPERATIONS | 1: R/NM | INC | 18 | R(N) + 1 → R(N) | 1 | 8 | N | N |  | 0 | 0 | 0 | 1 | 1 | 0 | 0 | 0 | 0 | 0 | 0 | 0 | 1 | 1 | 0 | 24 => '30',
REGISTER OPERATIONS | 1: R/NM | INC | 19 | R(N) + 1 → R(N) | 1 | 9 | N | N |  | 1 | 0 | 0 | 1 | 1 | 0 | 0 | 0 | 0 | 0 | 0 | 0 | 1 | 1 | 0 | 25 => '30',
REGISTER OPERATIONS | 1: R/NM | INC | 1A | R(N) + 1 → R(N) | 1 | A | N | N |  | 0 | 1 | 0 | 1 | 1 | 0 | 0 | 0 | 0 | 0 | 0 | 0 | 1 | 1 | 0 | 26 => '30',
REGISTER OPERATIONS | 1: R/NM | INC | 1B | R(N) + 1 → R(N) | 1 | B | N | N |  | 1 | 1 | 0 | 1 | 1 | 0 | 0 | 0 | 0 | 0 | 0 | 0 | 1 | 1 | 0 | 27 => '30',
REGISTER OPERATIONS | 1: R/NM | INC | 1C | R(N) + 1 → R(N) | 1 | C | N | N |  | 0 | 0 | 1 | 1 | 1 | 0 | 0 | 0 | 0 | 0 | 0 | 0 | 1 | 1 | 0 | 28 => '30',
REGISTER OPERATIONS | 1: R/NM | INC | 1D | R(N) + 1 → R(N) | 1 | D | N | N |  | 1 | 0 | 1 | 1 | 1 | 0 | 0 | 0 | 0 | 0 | 0 | 0 | 1 | 1 | 0 | 29 => '30',
REGISTER OPERATIONS | 1: R/NM | INC | 1E | R(N) + 1 → R(N) | 1 | E | N | N |  | 0 | 1 | 1 | 1 | 1 | 0 | 0 | 0 | 0 | 0 | 0 | 0 | 1 | 1 | 0 | 30 => '30',
REGISTER OPERATIONS | 1: R/NM | INC | 1F | R(N) + 1 → R(N) | 1 | F | N | N |  | 1 | 1 | 1 | 1 | 1 | 0 | 0 | 0 | 0 | 0 | 0 | 0 | 1 | 1 | 0 | 31 => '30',
REGISTER OPERATIONS | 1: R/NM | DEC | 20 | R(N) - 1 → R(N) | 2 | 0 | N | N |  | 0 | 0 | 0 | 0 | 0 | 1 | 0 | 0 | 0 | 0 | 0 | 0 | 1 | 1 | 0 | 32 => '30',
REGISTER OPERATIONS | 1: R/NM | DEC | 21 | R(N) - 1 → R(N) | 2 | 1 | N | N |  | 1 | 0 | 0 | 0 | 0 | 1 | 0 | 0 | 0 | 0 | 0 | 0 | 1 | 1 | 0 | 33 => '30',
REGISTER OPERATIONS | 1: R/NM | DEC | 22 | R(N) - 1 → R(N) | 2 | 2 | N | N |  | 0 | 1 | 0 | 0 | 0 | 1 | 0 | 0 | 0 | 0 | 0 | 0 | 1 | 1 | 0 | 34 => '30',
REGISTER OPERATIONS | 1: R/NM | DEC | 23 | R(N) - 1 → R(N) | 2 | 3 | N | N |  | 1 | 1 | 0 | 0 | 0 | 1 | 0 | 0 | 0 | 0 | 0 | 0 | 1 | 1 | 0 | 35 => '30',
REGISTER OPERATIONS | 1: R/NM | DEC | 24 | R(N) - 1 → R(N) | 2 | 4 | N | N |  | 0 | 0 | 1 | 0 | 0 | 1 | 0 | 0 | 0 | 0 | 0 | 0 | 1 | 1 | 0 | 36 => '30',
REGISTER OPERATIONS | 1: R/NM | DEC | 25 | R(N) - 1 → R(N) | 2 | 5 | N | N |  | 1 | 0 | 1 | 0 | 0 | 1 | 0 | 0 | 0 | 0 | 0 | 0 | 1 | 1 | 0 | 37 => '30',
REGISTER OPERATIONS | 1: R/NM | DEC | 26 | R(N) - 1 → R(N) | 2 | 6 | N | N |  | 0 | 1 | 1 | 0 | 0 | 1 | 0 | 0 | 0 | 0 | 0 | 0 | 1 | 1 | 0 | 38 => '30',
REGISTER OPERATIONS | 1: R/NM | DEC | 27 | R(N) - 1 → R(N) | 2 | 7 | N | N |  | 1 | 1 | 1 | 0 | 0 | 1 | 0 | 0 | 0 | 0 | 0 | 0 | 1 | 1 | 0 | 39 => '30',
REGISTER OPERATIONS | 1: R/NM | DEC | 28 | R(N) - 1 → R(N) | 2 | 8 | N | N |  | 0 | 0 | 0 | 1 | 0 | 1 | 0 | 0 | 0 | 0 | 0 | 0 | 1 | 1 | 0 | 40 => '30',
REGISTER OPERATIONS | 1: R/NM | DEC | 29 | R(N) - 1 → R(N) | 2 | 9 | N | N |  | 1 | 0 | 0 | 1 | 0 | 1 | 0 | 0 | 0 | 0 | 0 | 0 | 1 | 1 | 0 | 41 => '30',
REGISTER OPERATIONS | 1: R/NM | DEC | 2A | R(N) - 1 → R(N) | 2 | A | N | N |  | 0 | 1 | 0 | 1 | 0 | 1 | 0 | 0 | 0 | 0 | 0 | 0 | 1 | 1 | 0 | 42 => '30',
REGISTER OPERATIONS | 1: R/NM | DEC | 2B | R(N) - 1 → R(N) | 2 | B | N | N |  | 1 | 1 | 0 | 1 | 0 | 1 | 0 | 0 | 0 | 0 | 0 | 0 | 1 | 1 | 0 | 43 => '30',
REGISTER OPERATIONS | 1: R/NM | DEC | 2C | R(N) - 1 → R(N) | 2 | C | N | N |  | 0 | 0 | 1 | 1 | 0 | 1 | 0 | 0 | 0 | 0 | 0 | 0 | 1 | 1 | 0 | 44 => '30',
REGISTER OPERATIONS | 1: R/NM | DEC | 2D | R(N) - 1 → R(N) | 2 | D | N | N |  | 1 | 0 | 1 | 1 | 0 | 1 | 0 | 0 | 0 | 0 | 0 | 0 | 1 | 1 | 0 | 45 => '30',
REGISTER OPERATIONS | 1: R/NM | DEC | 2E | R(N) - 1 → R(N) | 2 | E | N | N |  | 0 | 1 | 1 | 1 | 0 | 1 | 0 | 0 | 0 | 0 | 0 | 0 | 1 | 1 | 0 | 46 => '30',
REGISTER OPERATIONS | 1: R/NM | DEC | 2F | R(N) - 1 → R(N) | 2 | F | N | N |  | 1 | 1 | 1 | 1 | 0 | 1 | 0 | 0 | 0 | 0 | 0 | 0 | 1 | 1 | 0 | 47 => '30',
REGISTER OPERATIONS | 1: R/NM | IRX | 60 | R(X) + 1 → R(X) | 6 | 0 | Y | N |  | 0 | 0 | 0 | 0 | 0 | 1 | 1 | 0 | 0 | 0 | 0 | 0 | 1 | 1 | 0 | 96 => '30',
REGISTER OPERATIONS | 1: R/NM | GLO | 80 | R(N).0 → D | 8 | 0 | N | N |  | 0 | 0 | 0 | 0 | 0 | 0 | 0 | 1 | 0 | 0 | 0 | 0 | 1 | 1 | 0 | 128 => '30',
REGISTER OPERATIONS | 1: R/NM | GLO | 81 | R(N).0 → D | 8 | 1 | N | N |  | 1 | 0 | 0 | 0 | 0 | 0 | 0 | 1 | 0 | 0 | 0 | 0 | 1 | 1 | 0 | 129 => '30',
REGISTER OPERATIONS | 1: R/NM | GLO | 82 | R(N).0 → D | 8 | 2 | N | N |  | 0 | 1 | 0 | 0 | 0 | 0 | 0 | 1 | 0 | 0 | 0 | 0 | 1 | 1 | 0 | 130 => '30',
REGISTER OPERATIONS | 1: R/NM | GLO | 83 | R(N).0 → D | 8 | 3 | N | N |  | 1 | 1 | 0 | 0 | 0 | 0 | 0 | 1 | 0 | 0 | 0 | 0 | 1 | 1 | 0 | 131 => '30',
REGISTER OPERATIONS | 1: R/NM | GLO | 84 | R(N).0 → D | 8 | 4 | N | N |  | 0 | 0 | 1 | 0 | 0 | 0 | 0 | 1 | 0 | 0 | 0 | 0 | 1 | 1 | 0 | 132 => '30',
REGISTER OPERATIONS | 1: R/NM | GLO | 85 | R(N).0 → D | 8 | 5 | N | N |  | 1 | 0 | 1 | 0 | 0 | 0 | 0 | 1 | 0 | 0 | 0 | 0 | 1 | 1 | 0 | 133 => '30',
REGISTER OPERATIONS | 1: R/NM | GLO | 86 | R(N).0 → D | 8 | 6 | N | N |  | 0 | 1 | 1 | 0 | 0 | 0 | 0 | 1 | 0 | 0 | 0 | 0 | 1 | 1 | 0 | 134 => '30',
REGISTER OPERATIONS | 1: R/NM | GLO | 87 | R(N).0 → D | 8 | 7 | N | N |  | 1 | 1 | 1 | 0 | 0 | 0 | 0 | 1 | 0 | 0 | 0 | 0 | 1 | 1 | 0 | 135 => '30',
REGISTER OPERATIONS | 1: R/NM | GLO | 88 | R(N).0 → D | 8 | 8 | N | N |  | 0 | 0 | 0 | 1 | 0 | 0 | 0 | 1 | 0 | 0 | 0 | 0 | 1 | 1 | 0 | 136 => '30',
REGISTER OPERATIONS | 1: R/NM | GLO | 89 | R(N).0 → D | 8 | 9 | N | N |  | 1 | 0 | 0 | 1 | 0 | 0 | 0 | 1 | 0 | 0 | 0 | 0 | 1 | 1 | 0 | 137 => '30',
REGISTER OPERATIONS | 1: R/NM | GLO | 8A | R(N).0 → D | 8 | A | N | N |  | 0 | 1 | 0 | 1 | 0 | 0 | 0 | 1 | 0 | 0 | 0 | 0 | 1 | 1 | 0 | 138 => '30',
REGISTER OPERATIONS | 1: R/NM | GLO | 8B | R(N).0 → D | 8 | B | N | N |  | 1 | 1 | 0 | 1 | 0 | 0 | 0 | 1 | 0 | 0 | 0 | 0 | 1 | 1 | 0 | 139 => '30',
REGISTER OPERATIONS | 1: R/NM | GLO | 8C | R(N).0 → D | 8 | C | N | N |  | 0 | 0 | 1 | 1 | 0 | 0 | 0 | 1 | 0 | 0 | 0 | 0 | 1 | 1 | 0 | 140 => '30',
REGISTER OPERATIONS | 1: R/NM | GLO | 8D | R(N).0 → D | 8 | D | N | N |  | 1 | 0 | 1 | 1 | 0 | 0 | 0 | 1 | 0 | 0 | 0 | 0 | 1 | 1 | 0 | 141 => '30',
REGISTER OPERATIONS | 1: R/NM | GLO | 8E | R(N).0 → D | 8 | E | N | N |  | 0 | 1 | 1 | 1 | 0 | 0 | 0 | 1 | 0 | 0 | 0 | 0 | 1 | 1 | 0 | 142 => '30',
REGISTER OPERATIONS | 1: R/NM | GLO | 8F | R(N).0 → D | 8 | F | N | N |  | 1 | 1 | 1 | 1 | 0 | 0 | 0 | 1 | 0 | 0 | 0 | 0 | 1 | 1 | 0 | 143 => '30',
REGISTER OPERATIONS | 1: R/NM | PLO | A0 | D → R(N).0 | A | 0 | N | N |  | 0 | 0 | 0 | 0 | 0 | 1 | 0 | 1 | 0 | 0 | 0 | 0 | 1 | 1 | 0 | 160 => '30',
REGISTER OPERATIONS | 1: R/NM | PLO | A1 | D → R(N).0 | A | 1 | N | N |  | 1 | 0 | 0 | 0 | 0 | 1 | 0 | 1 | 0 | 0 | 0 | 0 | 1 | 1 | 0 | 161 => '30',
REGISTER OPERATIONS | 1: R/NM | PLO | A2 | D → R(N).0 | A | 2 | N | N |  | 0 | 1 | 0 | 0 | 0 | 1 | 0 | 1 | 0 | 0 | 0 | 0 | 1 | 1 | 0 | 162 => '30',
REGISTER OPERATIONS | 1: R/NM | PLO | A3 | D → R(N).0 | A | 3 | N | N |  | 1 | 1 | 0 | 0 | 0 | 1 | 0 | 1 | 0 | 0 | 0 | 0 | 1 | 1 | 0 | 163 => '30',
REGISTER OPERATIONS | 1: R/NM | PLO | A4 | D → R(N).0 | A | 4 | N | N |  | 0 | 0 | 1 | 0 | 0 | 1 | 0 | 1 | 0 | 0 | 0 | 0 | 1 | 1 | 0 | 164 => '30',
REGISTER OPERATIONS | 1: R/NM | PLO | A5 | D → R(N).0 | A | 5 | N | N |  | 1 | 0 | 1 | 0 | 0 | 1 | 0 | 1 | 0 | 0 | 0 | 0 | 1 | 1 | 0 | 165 => '30',
REGISTER OPERATIONS | 1: R/NM | PLO | A6 | D → R(N).0 | A | 6 | N | N |  | 0 | 1 | 1 | 0 | 0 | 1 | 0 | 1 | 0 | 0 | 0 | 0 | 1 | 1 | 0 | 166 => '30',
REGISTER OPERATIONS | 1: R/NM | PLO | A7 | D → R(N).0 | A | 7 | N | N |  | 1 | 1 | 1 | 0 | 0 | 1 | 0 | 1 | 0 | 0 | 0 | 0 | 1 | 1 | 0 | 167 => '30',
REGISTER OPERATIONS | 1: R/NM | PLO | A8 | D → R(N).0 | A | 8 | N | N |  | 0 | 0 | 0 | 1 | 0 | 1 | 0 | 1 | 0 | 0 | 0 | 0 | 1 | 1 | 0 | 168 => '30',
REGISTER OPERATIONS | 1: R/NM | PLO | A9 | D → R(N).0 | A | 9 | N | N |  | 1 | 0 | 0 | 1 | 0 | 1 | 0 | 1 | 0 | 0 | 0 | 0 | 1 | 1 | 0 | 169 => '30',
REGISTER OPERATIONS | 1: R/NM | PLO | AA | D → R(N).0 | A | A | N | N |  | 0 | 1 | 0 | 1 | 0 | 1 | 0 | 1 | 0 | 0 | 0 | 0 | 1 | 1 | 0 | 170 => '30',
REGISTER OPERATIONS | 1: R/NM | PLO | AB | D → R(N).0 | A | B | N | N |  | 1 | 1 | 0 | 1 | 0 | 1 | 0 | 1 | 0 | 0 | 0 | 0 | 1 | 1 | 0 | 171 => '30',
REGISTER OPERATIONS | 1: R/NM | PLO | AC | D → R(N).0 | A | C | N | N |  | 0 | 0 | 1 | 1 | 0 | 1 | 0 | 1 | 0 | 0 | 0 | 0 | 1 | 1 | 0 | 172 => '30',
REGISTER OPERATIONS | 1: R/NM | PLO | AD | D → R(N).0 | A | D | N | N |  | 1 | 0 | 1 | 1 | 0 | 1 | 0 | 1 | 0 | 0 | 0 | 0 | 1 | 1 | 0 | 173 => '30',
REGISTER OPERATIONS | 1: R/NM | PLO | AE | D → R(N).0 | A | E | N | N |  | 0 | 1 | 1 | 1 | 0 | 1 | 0 | 1 | 0 | 0 | 0 | 0 | 1 | 1 | 0 | 174 => '30',
REGISTER OPERATIONS | 1: R/NM | PLO | AF | D → R(N).0 | A | F | N | N |  | 1 | 1 | 1 | 1 | 0 | 1 | 0 | 1 | 0 | 0 | 0 | 0 | 1 | 1 | 0 | 175 => '30',
REGISTER OPERATIONS | 1: R/NM | GHI | 90 | R(N).1 → D | 9 | 0 | N | N |  | 0 | 0 | 0 | 0 | 1 | 0 | 0 | 1 | 0 | 0 | 0 | 0 | 1 | 1 | 0 | 144 => '30',
REGISTER OPERATIONS | 1: R/NM | GHI | 91 | R(N).1 → D | 9 | 1 | N | N |  | 1 | 0 | 0 | 0 | 1 | 0 | 0 | 1 | 0 | 0 | 0 | 0 | 1 | 1 | 0 | 145 => '30',
REGISTER OPERATIONS | 1: R/NM | GHI | 92 | R(N).1 → D | 9 | 2 | N | N |  | 0 | 1 | 0 | 0 | 1 | 0 | 0 | 1 | 0 | 0 | 0 | 0 | 1 | 1 | 0 | 146 => '30',
REGISTER OPERATIONS | 1: R/NM | GHI | 93 | R(N).1 → D | 9 | 3 | N | N |  | 1 | 1 | 0 | 0 | 1 | 0 | 0 | 1 | 0 | 0 | 0 | 0 | 1 | 1 | 0 | 147 => '30',
REGISTER OPERATIONS | 1: R/NM | GHI | 94 | R(N).1 → D | 9 | 4 | N | N |  | 0 | 0 | 1 | 0 | 1 | 0 | 0 | 1 | 0 | 0 | 0 | 0 | 1 | 1 | 0 | 148 => '30',
REGISTER OPERATIONS | 1: R/NM | GHI | 95 | R(N).1 → D | 9 | 5 | N | N |  | 1 | 0 | 1 | 0 | 1 | 0 | 0 | 1 | 0 | 0 | 0 | 0 | 1 | 1 | 0 | 149 => '30',
REGISTER OPERATIONS | 1: R/NM | GHI | 96 | R(N).1 → D | 9 | 6 | N | N |  | 0 | 1 | 1 | 0 | 1 | 0 | 0 | 1 | 0 | 0 | 0 | 0 | 1 | 1 | 0 | 150 => '30',
REGISTER OPERATIONS | 1: R/NM | GHI | 97 | R(N).1 → D | 9 | 7 | N | N |  | 1 | 1 | 1 | 0 | 1 | 0 | 0 | 1 | 0 | 0 | 0 | 0 | 1 | 1 | 0 | 151 => '30',
REGISTER OPERATIONS | 1: R/NM | GHI | 98 | R(N).1 → D | 9 | 8 | N | N |  | 0 | 0 | 0 | 1 | 1 | 0 | 0 | 1 | 0 | 0 | 0 | 0 | 1 | 1 | 0 | 152 => '30',
REGISTER OPERATIONS | 1: R/NM | GHI | 99 | R(N).1 → D | 9 | 9 | N | N |  | 1 | 0 | 0 | 1 | 1 | 0 | 0 | 1 | 0 | 0 | 0 | 0 | 1 | 1 | 0 | 153 => '30',
REGISTER OPERATIONS | 1: R/NM | GHI | 9A | R(N).1 → D | 9 | A | N | N |  | 0 | 1 | 0 | 1 | 1 | 0 | 0 | 1 | 0 | 0 | 0 | 0 | 1 | 1 | 0 | 154 => '30',
REGISTER OPERATIONS | 1: R/NM | GHI | 9B | R(N).1 → D | 9 | B | N | N |  | 1 | 1 | 0 | 1 | 1 | 0 | 0 | 1 | 0 | 0 | 0 | 0 | 1 | 1 | 0 | 155 => '30',
REGISTER OPERATIONS | 1: R/NM | GHI | 9C | R(N).1 → D | 9 | C | N | N |  | 0 | 0 | 1 | 1 | 1 | 0 | 0 | 1 | 0 | 0 | 0 | 0 | 1 | 1 | 0 | 156 => '30',
REGISTER OPERATIONS | 1: R/NM | GHI | 9D | R(N).1 → D | 9 | D | N | N |  | 1 | 0 | 1 | 1 | 1 | 0 | 0 | 1 | 0 | 0 | 0 | 0 | 1 | 1 | 0 | 157 => '30',
REGISTER OPERATIONS | 1: R/NM | GHI | 9E | R(N).1 → D | 9 | E | N | N |  | 0 | 1 | 1 | 1 | 1 | 0 | 0 | 1 | 0 | 0 | 0 | 0 | 1 | 1 | 0 | 158 => '30',
REGISTER OPERATIONS | 1: R/NM | GHI | 9F | R(N).1 → D | 9 | F | N | N |  | 1 | 1 | 1 | 1 | 1 | 0 | 0 | 1 | 0 | 0 | 0 | 0 | 1 | 1 | 0 | 159 => '30',
REGISTER OPERATIONS | 1: R/NM | PHI | B0 | D → R(N).1 | B | 0 | N | N |  | 0 | 0 | 0 | 0 | 1 | 1 | 0 | 1 | 0 | 0 | 0 | 0 | 1 | 1 | 0 | 176 => '30',
REGISTER OPERATIONS | 1: R/NM | PHI | B1 | D → R(N).1 | B | 1 | N | N |  | 1 | 0 | 0 | 0 | 1 | 1 | 0 | 1 | 0 | 0 | 0 | 0 | 1 | 1 | 0 | 177 => '30',
REGISTER OPERATIONS | 1: R/NM | PHI | B2 | D → R(N).1 | B | 2 | N | N |  | 0 | 1 | 0 | 0 | 1 | 1 | 0 | 1 | 0 | 0 | 0 | 0 | 1 | 1 | 0 | 178 => '30',
REGISTER OPERATIONS | 1: R/NM | PHI | B3 | D → R(N).1 | B | 3 | N | N |  | 1 | 1 | 0 | 0 | 1 | 1 | 0 | 1 | 0 | 0 | 0 | 0 | 1 | 1 | 0 | 179 => '30',
REGISTER OPERATIONS | 1: R/NM | PHI | B4 | D → R(N).1 | B | 4 | N | N |  | 0 | 0 | 1 | 0 | 1 | 1 | 0 | 1 | 0 | 0 | 0 | 0 | 1 | 1 | 0 | 180 => '30',
REGISTER OPERATIONS | 1: R/NM | PHI | B5 | D → R(N).1 | B | 5 | N | N |  | 1 | 0 | 1 | 0 | 1 | 1 | 0 | 1 | 0 | 0 | 0 | 0 | 1 | 1 | 0 | 181 => '30',
REGISTER OPERATIONS | 1: R/NM | PHI | B6 | D → R(N).1 | B | 6 | N | N |  | 0 | 1 | 1 | 0 | 1 | 1 | 0 | 1 | 0 | 0 | 0 | 0 | 1 | 1 | 0 | 182 => '30',
REGISTER OPERATIONS | 1: R/NM | PHI | B7 | D → R(N).1 | B | 7 | N | N |  | 1 | 1 | 1 | 0 | 1 | 1 | 0 | 1 | 0 | 0 | 0 | 0 | 1 | 1 | 0 | 183 => '30',
REGISTER OPERATIONS | 1: R/NM | PHI | B8 | D → R(N).1 | B | 8 | N | N |  | 0 | 0 | 0 | 1 | 1 | 1 | 0 | 1 | 0 | 0 | 0 | 0 | 1 | 1 | 0 | 184 => '30',
REGISTER OPERATIONS | 1: R/NM | PHI | B9 | D → R(N).1 | B | 9 | N | N |  | 1 | 0 | 0 | 1 | 1 | 1 | 0 | 1 | 0 | 0 | 0 | 0 | 1 | 1 | 0 | 185 => '30',
REGISTER OPERATIONS | 1: R/NM | PHI | BA | D → R(N).1 | B | A | N | N |  | 0 | 1 | 0 | 1 | 1 | 1 | 0 | 1 | 0 | 0 | 0 | 0 | 1 | 1 | 0 | 186 => '30',
REGISTER OPERATIONS | 1: R/NM | PHI | BB | D → R(N).1 | B | B | N | N |  | 1 | 1 | 0 | 1 | 1 | 1 | 0 | 1 | 0 | 0 | 0 | 0 | 1 | 1 | 0 | 187 => '30',
REGISTER OPERATIONS | 1: R/NM | PHI | BC | D → R(N).1 | B | C | N | N |  | 0 | 0 | 1 | 1 | 1 | 1 | 0 | 1 | 0 | 0 | 0 | 0 | 1 | 1 | 0 | 188 => '30',
REGISTER OPERATIONS | 1: R/NM | PHI | BD | D → R(N).1 | B | D | N | N |  | 1 | 0 | 1 | 1 | 1 | 1 | 0 | 1 | 0 | 0 | 0 | 0 | 1 | 1 | 0 | 189 => '30',
REGISTER OPERATIONS | 1: R/NM | PHI | BE | D → R(N).1 | B | E | N | N |  | 0 | 1 | 1 | 1 | 1 | 1 | 0 | 1 | 0 | 0 | 0 | 0 | 1 | 1 | 0 | 190 => '30',
REGISTER OPERATIONS | 1: R/NM | PHI | BF | D → R(N).1 | B | F | N | N |  | 1 | 1 | 1 | 1 | 1 | 1 | 0 | 1 | 0 | 0 | 0 | 0 | 1 | 1 | 0 | 191 => '30',
LOGIC OPERATIONS | 3: R/R | OR | F1 | M(R(X)) OR D → D | F | 1 | Y | Y | X | 1 | 0 | 0 | 0 | 1 | 1 | 1 | 1 | 0 | 0 | 0 | 0 | 1 | 0 | 1 | 241 => '50',
LOGIC OPERATIONS | 3: R/R | ORI | F9 | M(R(P)) OR D → D; R(P) + 1 → R(P) | F | 9 | N | Y | P | 1 | 0 | 0 | 1 | 1 | 1 | 1 | 1 | 0 | 0 | 0 | 0 | 1 | 1 | 0 | 249 => '30',
LOGIC OPERATIONS | 3: R/R | XOR | F3 | M(R(X)) XOR D → D | F | 3 | Y | Y | X | 1 | 1 | 0 | 0 | 1 | 1 | 1 | 1 | 0 | 0 | 0 | 0 | 1 | 0 | 1 | 243 => '50',
LOGIC OPERATIONS | 3: R/R | XRI | FB | M(R(P)) XOR D → D; R(P) + 1 → R(P) | F | B | N | Y | P | 1 | 1 | 0 | 1 | 1 | 1 | 1 | 1 | 0 | 0 | 0 | 0 | 1 | 1 | 0 | 251 => '30',
LOGIC OPERATIONS | 3: R/R | AND | F2 | M(R(X)) AND D → D | F | 2 | Y | Y | X | 0 | 1 | 0 | 0 | 1 | 1 | 1 | 1 | 0 | 0 | 0 | 0 | 1 | 0 | 1 | 242 => '50',
LOGIC OPERATIONS | 3: R/R | ANI | FA | M(R(P)) AND D → D; R(P) + 1 → R(P) | F | A | N | Y | P | 0 | 1 | 0 | 1 | 1 | 1 | 1 | 1 | 0 | 0 | 0 | 0 | 1 | 1 | 0 | 250 => '30',
LOGIC OPERATIONS | 1: R/NM | SHR | F6 | SHIFT D RIGHT, LSB(D) → DF, 0 → MSB(D) | F | 6 | N | N |  | 0 | 1 | 1 | 0 | 1 | 1 | 1 | 1 | 0 | 0 | 0 | 0 | 1 | 1 | 0 | 246 => '30',
LOGIC OPERATIONS | 1: R/NM | SHRC | 76 | SHIFT D RIGHT, LSB(D) → DF, DF → MSB(D) | 7 | 6 | N | N |  | 0 | 1 | 1 | 0 | 1 | 1 | 1 | 0 | 0 | 0 | 0 | 0 | 1 | 1 | 0 | 118 => '30',
LOGIC OPERATIONS | 1: R/NM | SHL | FE | SHIFT D LEFT, MSB(D) → DF, 0 → LSB(D) | F | E | N | N |  | 0 | 1 | 1 | 1 | 1 | 1 | 1 | 1 | 0 | 0 | 0 | 0 | 1 | 1 | 0 | 254 => '30',
LOGIC OPERATIONS | 1: R/NM | SHLC | 7E | SHIFT D LEFT, MSB(D) → DF, DF → LSB(D) | 7 | E | N | N |  | 0 | 1 | 1 | 1 | 1 | 1 | 1 | 0 | 0 | 0 | 0 | 0 | 1 | 1 | 0 | 126 => '30',
ARITHMETIC OPERATIONS | 3: R/R | ADD | F4 | M(R(X)) + D → DF, D | F | 4 | Y | Y | X | 0 | 0 | 1 | 0 | 1 | 1 | 1 | 1 | 0 | 0 | 0 | 0 | 1 | 0 | 1 | 244 => '50',
ARITHMETIC OPERATIONS | 3: R/R | ADI | FC | M(R(P)) + D → DF, D; R(P) + 1 → R(P) | F | C | N | Y | P | 0 | 0 | 1 | 1 | 1 | 1 | 1 | 1 | 0 | 0 | 0 | 0 | 1 | 1 | 0 | 252 => '30',
ARITHMETIC OPERATIONS | 3: R/R | ADC | 74 | M(R(X)) + D + DF → DF, D | 7 | 4 | Y | Y | X | 0 | 0 | 1 | 0 | 1 | 1 | 1 | 0 | 0 | 0 | 0 | 0 | 1 | 0 | 1 | 116 => '50',
ARITHMETIC OPERATIONS | 3: R/R | ADCI | 7C | M(R(P)) + D + DF → DF, D; R(P) + 1 → R(P) | 7 | C | N | Y | P | 0 | 0 | 1 | 1 | 1 | 1 | 1 | 0 | 0 | 0 | 0 | 0 | 1 | 1 | 0 | 124 => '30',
ARITHMETIC OPERATIONS | 3: R/R | SD | F5 | M(R(X)) - D → DF, D | F | 5 | Y | Y | X | 1 | 0 | 1 | 0 | 1 | 1 | 1 | 1 | 0 | 0 | 0 | 0 | 1 | 0 | 1 | 245 => '50',
ARITHMETIC OPERATIONS | 3: R/R | SDI | FD | M(R(P)) - D → DF, D; R(P) + 1 → R(P) | F | D | N | Y | P | 1 | 0 | 1 | 1 | 1 | 1 | 1 | 1 | 0 | 0 | 0 | 0 | 1 | 1 | 0 | 253 => '30',
ARITHMETIC OPERATIONS | 3: R/R | SDB | 75 | M(R(X)) - D - (NOT DF) → DF, D | 7 | 5 | Y | Y | X | 1 | 0 | 1 | 0 | 1 | 1 | 1 | 0 | 0 | 0 | 0 | 0 | 1 | 0 | 1 | 117 => '50',
ARITHMETIC OPERATIONS | 3: R/R | SDBI | 7D | M(R(P)) - D - (Not DF) → DF, D; R(P) + 1 → R(P) | 7 | D | N | Y | P | 1 | 0 | 1 | 1 | 1 | 1 | 1 | 0 | 0 | 0 | 0 | 0 | 1 | 1 | 0 | 125 => '30',
ARITHMETIC OPERATIONS | 3: R/R | SM | F7 | D-M(R(X)) → DF, D | F | 7 | Y | Y | X | 1 | 1 | 1 | 0 | 1 | 1 | 1 | 1 | 0 | 0 | 0 | 0 | 1 | 0 | 1 | 247 => '50',
ARITHMETIC OPERATIONS | 3: R/R | SMI | FF | D-M(R(P)) → DF, D; R(P) + 1 → R(P) | F | F | N | Y | P | 1 | 1 | 1 | 1 | 1 | 1 | 1 | 1 | 0 | 0 | 0 | 0 | 1 | 1 | 0 | 255 => '30',
ARITHMETIC OPERATIONS | 3: R/R | SMB | 77 | D-M(R(X))-(NOT DF) → DF, D | 7 | 7 | Y | Y | X | 1 | 1 | 1 | 0 | 1 | 1 | 1 | 0 | 0 | 0 | 0 | 0 | 1 | 0 | 1 | 119 => '50',
ARITHMETIC OPERATIONS | 3: R/R | SMBI | 7F | D-M(R(P))-(NOT DF) → DF, D; R(P) + 1 → R(P) | 7 | F | N | Y | P | 1 | 1 | 1 | 1 | 1 | 1 | 1 | 0 | 0 | 0 | 0 | 0 | 1 | 1 | 0 | 127 => '30',
BRANCH - SHORT | 3: R/R | BR | 30 | M(R(P)) → R(P).0 | 3 | 0 | N | Y | P | 0 | 0 | 0 | 0 | 1 | 1 | 0 | 0 | 0 | 0 | 0 | 0 | 1 | 1 | 0 | 48 => '30',
BRANCH - SHORT | 3: R/R | BZ | 32 | IF D = 0, M(R(P)) → R(P).0, ELSE R(P) + 1 → R(P) | 3 | 2 | N | Y | P | 0 | 1 | 0 | 0 | 1 | 1 | 0 | 0 | 0 | 0 | 0 | 0 | 1 | 1 | 0 | 50 => '30',
BRANCH - SHORT | 3: R/R | BNZ | 3A | IF D NOT 0, M(R(P)) → R(P).0, ELSE R(P) + 1 → R(P) | 3 | A | N | Y | P | 0 | 1 | 0 | 1 | 1 | 1 | 0 | 0 | 0 | 0 | 0 | 0 | 1 | 1 | 0 | 58 => '30',
BRANCH - SHORT | 3: R/R | BDF | 33 | IF DF = 1, M(R(P)) → R(P).0, ELSE R(P) + 1 → R(P) | 3 | 3 | N | Y | P | 1 | 1 | 0 | 0 | 1 | 1 | 0 | 0 | 0 | 0 | 0 | 0 | 1 | 1 | 0 | 51 => '30',
BRANCH - SHORT | 3: R/R | BNF | 3B | IF DF = 0, M(R(P)) → R(P).0, ELSE R(P) + 1 → R(P) | 3 | B | N | Y | P | 1 | 1 | 0 | 1 | 1 | 1 | 0 | 0 | 0 | 0 | 0 | 0 | 1 | 1 | 0 | 59 => '30',
BRANCH - SHORT | 3: R/R | BQ | 31 | IF Q = 1, M(R(P)) → R(P).0, ELSE R(P) + 1 → R(P) | 3 | 1 | N | Y | P | 1 | 0 | 0 | 0 | 1 | 1 | 0 | 0 | 0 | 0 | 0 | 0 | 1 | 1 | 0 | 49 => '30',
BRANCH - SHORT | 3: R/R | BNQ | 39 | IF Q = 0, M(R(P)) → R(P).0, ELSE R(P) + 1 → R(P) | 3 | 9 | N | Y | P | 1 | 0 | 0 | 1 | 1 | 1 | 0 | 0 | 0 | 0 | 0 | 0 | 1 | 1 | 0 | 57 => '30',
BRANCH - SHORT | 3: R/R | B1 | 34 | IF EF1 =1, M(R(P)) → R(P).0, ELSE R(P) + 1 → R(P) | 3 | 4 | N | Y | P | 0 | 0 | 1 | 0 | 1 | 1 | 0 | 0 | 0 | 0 | 0 | 0 | 1 | 1 | 0 | 52 => '30',
BRANCH - SHORT | 3: R/R | BN1 | 3C | IF EF1 = 0, M(R(P)) → R(P).0, ELSE R(P) + 1 → R(P) | 3 | C | N | Y | P | 0 | 0 | 1 | 1 | 1 | 1 | 0 | 0 | 0 | 0 | 0 | 0 | 1 | 1 | 0 | 60 => '30',
BRANCH - SHORT | 3: R/R | B2 | 35 | IF EF2 = 1, M(R(P)) → R(P).0, ELSE R(P) + 1 → R(P) | 3 | 5 | N | Y | P | 1 | 0 | 1 | 0 | 1 | 1 | 0 | 0 | 0 | 0 | 0 | 0 | 1 | 1 | 0 | 53 => '30',
BRANCH - SHORT | 3: R/R | BN2 | 3D | IF EF2 = 0, M(R(P)) → R(P).0, ELSE R(P) + 1 → R(P) | 3 | D | N | Y | P | 1 | 0 | 1 | 1 | 1 | 1 | 0 | 0 | 0 | 0 | 0 | 0 | 1 | 1 | 0 | 61 => '30',
BRANCH - SHORT | 3: R/R | B3 | 36 | IF EF3 = 1, M(R(P)) → R(P).0, ELSE R(P) + 1 → R(P) | 3 | 6 | N | Y | P | 0 | 1 | 1 | 0 | 1 | 1 | 0 | 0 | 0 | 0 | 0 | 0 | 1 | 1 | 0 | 54 => '30',
BRANCH - SHORT | 3: R/R | BN3 | 3E | IF EF3 = 0, M(R(P)) → R(P).0, ELSE R(P) + 1 → R(P) | 3 | E | N | Y | P | 0 | 1 | 1 | 1 | 1 | 1 | 0 | 0 | 0 | 0 | 0 | 0 | 1 | 1 | 0 | 62 => '30',
BRANCH - SHORT | 3: R/R | B4 | 37 | IF EF4 = 1, M(R(P)) → R(P).0, ELSE R(P) + 1 → R(P) | 3 | 7 | N | Y | P | 1 | 1 | 1 | 0 | 1 | 1 | 0 | 0 | 0 | 0 | 0 | 0 | 1 | 1 | 0 | 55 => '30',
BRANCH - SHORT | 3: R/R | BN4 | 3F | IF EF4 = 0, M(R(P)) → R(P).0, ELSE R(P) + 1 → R(P) | 3 | F | N | Y | P | 1 | 1 | 1 | 1 | 1 | 1 | 0 | 0 | 0 | 0 | 0 | 0 | 1 | 1 | 0 | 63 => '30',
BRANCH - LONG | 4: R/R/R | LBR | C0 | M(R(P)) → R(P). 1, M(R(P) + 1) → R(P).0 | C | 0 | N | Y | P | 0 | 0 | 0 | 0 | 0 | 0 | 1 | 1 | 0 | 0 | 0 | 0 | 1 | 1 | 0 | 192 => '30',
BRANCH - LONG | 4: R/R/R | LBZ | C2 | lF D = 0, M(R(P)) → R(P).1, M(R(P) +1) → R(P).0, ELSE R(P) + 2 → R(P) | C | 2 | N | Y | P | 0 | 1 | 0 | 0 | 0 | 0 | 1 | 1 | 0 | 0 | 0 | 0 | 1 | 1 | 0 | 194 => '30',
BRANCH - LONG | 4: R/R/R | LBNZ | CA | IF D Not 0, M(R(P))→ R(P).1, M(R(P) + 1)→ R(P).0, ELSE R(P) + 2→ R(P) | C | A | N | Y | P | 0 | 1 | 0 | 1 | 0 | 0 | 1 | 1 | 0 | 0 | 0 | 0 | 1 | 1 | 0 | 202 => '30',
BRANCH - LONG | 4: R/R/R | LBDF | C3 | lF DF = 1, M(R(P))→ R(P).1, M(R(P) + 1)→ R(P).0, ELSE R(P) + 2 → R(P) | C | 3 | N | Y | P | 1 | 1 | 0 | 0 | 0 | 0 | 1 | 1 | 0 | 0 | 0 | 0 | 1 | 1 | 0 | 195 => '30',
BRANCH - LONG | 4: R/R/R | LBNF | CB | IF DF = 0, M(R(P))→ R(P).1, M(R(P) + 1)→ R(P).0, ELSE R(P) + 2 → R(P) | C | B | N | Y | P | 1 | 1 | 0 | 1 | 0 | 0 | 1 | 1 | 0 | 0 | 0 | 0 | 1 | 1 | 0 | 203 => '30',
BRANCH - LONG | 4: R/R/R | LBQ | C1 | IF Q = 1, M(R(P)) → R(P).1, M(R(P) + 1) → R(P).0, ELSE R(P) + 2 → R(P) | C | 1 | N | Y | P | 1 | 0 | 0 | 0 | 0 | 0 | 1 | 1 | 0 | 0 | 0 | 0 | 1 | 1 | 0 | 193 => '30',
BRANCH - LONG | 4: R/R/R | LBNQ | C9 | lF Q = 0, M(R(P)) → R(P).1, M(R(P) + 1) → R(P).0, ELSE R(P) + 2 → R(P) | C | 9 | N | Y | P | 1 | 0 | 0 | 1 | 0 | 0 | 1 | 1 | 0 | 0 | 0 | 0 | 1 | 1 | 0 | 201 => '30',
SKIP INSTRUCTIONS | 5: R/NM/NM | LSKP | C8 | R(P) = 2 → R(P) | C | 8 | N | N |  | 0 | 0 | 0 | 1 | 0 | 0 | 1 | 1 | 0 | 0 | 0 | 0 | 1 | 1 | 0 | 200 => '30',
SKIP INSTRUCTIONS | 5: R/NM/NM | SKP | 38 | R(P) + 1 → R(P) | 3 | 8 | N | N |  | 0 | 0 | 0 | 1 | 1 | 1 | 0 | 0 | 0 | 0 | 0 | 0 | 1 | 1 | 0 | 56 => '30',
SKIP INSTRUCTIONS | 5: R/NM/NM | LSZ | CE | IF D = 0, R(P) + 2 → R(P), ELSE CONTINUE | C | E | N | N |  | 0 | 1 | 1 | 1 | 0 | 0 | 1 | 1 | 0 | 0 | 0 | 0 | 1 | 1 | 0 | 206 => '30',
SKIP INSTRUCTIONS | 5: R/NM/NM | LSNZ | C6 | IF D Not 0, R(P) + 2 → R(P), ELSE CONTINUE | C | 6 | N | N |  | 0 | 1 | 1 | 0 | 0 | 0 | 1 | 1 | 0 | 0 | 0 | 0 | 1 | 1 | 0 | 198 => '30',
SKIP INSTRUCTIONS | 5: R/NM/NM | LSDF | CF | IF DF = 1, R(P) + 2 → R(P), ELSE CONTINUE | C | F | N | N |  | 1 | 1 | 1 | 1 | 0 | 0 | 1 | 1 | 0 | 0 | 0 | 0 | 1 | 1 | 0 | 207 => '30',
SKIP INSTRUCTIONS | 5: R/NM/NM | LSNF | C7 | IF DF = 0, R(P) + 2 → R(P), ELSE CONTINUE | C | 7 | N | N |  | 1 | 1 | 1 | 0 | 0 | 0 | 1 | 1 | 0 | 0 | 0 | 0 | 1 | 1 | 0 | 199 => '30',
SKIP INSTRUCTIONS | 5: R/NM/NM | LSQ | CD | IF Q = 1, R(P) + 2 → R(P), ELSE CONTINUE | C | D | N | N |  | 1 | 0 | 1 | 1 | 0 | 0 | 1 | 1 | 0 | 0 | 0 | 0 | 1 | 1 | 0 | 205 => '30',
SKIP INSTRUCTIONS | 5: R/NM/NM | LSNQ | C5 | IF Q = 0, R(P) + 2 → R(P), ELSE CONTINUE | C | 5 | N | N |  | 1 | 0 | 1 | 0 | 0 | 0 | 1 | 1 | 0 | 0 | 0 | 0 | 1 | 1 | 0 | 197 => '30',
SKIP INSTRUCTIONS | 5: R/NM/NM | LSIE | CC | IF IE = 1, R(P) + 2 → R(P), ELSE CONTINUE | C | C | N | N |  | 0 | 0 | 1 | 1 | 0 | 0 | 1 | 1 | 0 | 0 | 0 | 0 | 1 | 1 | 0 | 204 => '30',
CONTROL | N/A | IDL | 00 | WAIT FOR DMA OR INTERRUPT; M(R(0)) → BUS | 0 | 0 | N | Y | 0 | 0 | 0 | 0 | 0 | 0 | 0 | 0 | 0 | 0 | 0 | 0 | 0 | 1 | 1 | 0 | 0 => '30',
CONTROL | 5: R/NM/NM | NOP | C4 | CONTINUE | C | 4 | N | N |  | 0 | 0 | 1 | 0 | 0 | 0 | 1 | 1 | 0 | 0 | 0 | 0 | 1 | 1 | 0 | 196 => '30',
CONTROL | 1: R/NM | SEP | D0 | N → P | D | 0 | N | N |  | 0 | 0 | 0 | 0 | 1 | 0 | 1 | 1 | 0 | 0 | 0 | 0 | 1 | 1 | 0 | 208 => '30',
CONTROL | 1: R/NM | SEP | D1 | N → P | D | 1 | N | N |  | 1 | 0 | 0 | 0 | 1 | 0 | 1 | 1 | 0 | 0 | 0 | 0 | 1 | 1 | 0 | 209 => '30',
CONTROL | 1: R/NM | SEP | D2 | N → P | D | 2 | N | N |  | 0 | 1 | 0 | 0 | 1 | 0 | 1 | 1 | 0 | 0 | 0 | 0 | 1 | 1 | 0 | 210 => '30',
CONTROL | 1: R/NM | SEP | D3 | N → P | D | 3 | N | N |  | 1 | 1 | 0 | 0 | 1 | 0 | 1 | 1 | 0 | 0 | 0 | 0 | 1 | 1 | 0 | 211 => '30',
CONTROL | 1: R/NM | SEP | D4 | N → P | D | 4 | N | N |  | 0 | 0 | 1 | 0 | 1 | 0 | 1 | 1 | 0 | 0 | 0 | 0 | 1 | 1 | 0 | 212 => '30',
CONTROL | 1: R/NM | SEP | D5 | N → P | D | 5 | N | N |  | 1 | 0 | 1 | 0 | 1 | 0 | 1 | 1 | 0 | 0 | 0 | 0 | 1 | 1 | 0 | 213 => '30',
CONTROL | 1: R/NM | SEP | D6 | N → P | D | 6 | N | N |  | 0 | 1 | 1 | 0 | 1 | 0 | 1 | 1 | 0 | 0 | 0 | 0 | 1 | 1 | 0 | 214 => '30',
CONTROL | 1: R/NM | SEP | D7 | N → P | D | 7 | N | N |  | 1 | 1 | 1 | 0 | 1 | 0 | 1 | 1 | 0 | 0 | 0 | 0 | 1 | 1 | 0 | 215 => '30',
CONTROL | 1: R/NM | SEP | D8 | N → P | D | 8 | N | N |  | 0 | 0 | 0 | 1 | 1 | 0 | 1 | 1 | 0 | 0 | 0 | 0 | 1 | 1 | 0 | 216 => '30',
CONTROL | 1: R/NM | SEP | D9 | N → P | D | 9 | N | N |  | 1 | 0 | 0 | 1 | 1 | 0 | 1 | 1 | 0 | 0 | 0 | 0 | 1 | 1 | 0 | 217 => '30',
CONTROL | 1: R/NM | SEP | DA | N → P | D | A | N | N |  | 0 | 1 | 0 | 1 | 1 | 0 | 1 | 1 | 0 | 0 | 0 | 0 | 1 | 1 | 0 | 218 => '30',
CONTROL | 1: R/NM | SEP | DB | N → P | D | B | N | N |  | 1 | 1 | 0 | 1 | 1 | 0 | 1 | 1 | 0 | 0 | 0 | 0 | 1 | 1 | 0 | 219 => '30',
CONTROL | 1: R/NM | SEP | DC | N → P | D | C | N | N |  | 0 | 0 | 1 | 1 | 1 | 0 | 1 | 1 | 0 | 0 | 0 | 0 | 1 | 1 | 0 | 220 => '30',
CONTROL | 1: R/NM | SEP | DD | N → P | D | D | N | N |  | 1 | 0 | 1 | 1 | 1 | 0 | 1 | 1 | 0 | 0 | 0 | 0 | 1 | 1 | 0 | 221 => '30',
CONTROL | 1: R/NM | SEP | DE | N → P | D | E | N | N |  | 0 | 1 | 1 | 1 | 1 | 0 | 1 | 1 | 0 | 0 | 0 | 0 | 1 | 1 | 0 | 222 => '30',
CONTROL | 1: R/NM | SEP | DF | N → P | D | F | N | N |  | 1 | 1 | 1 | 1 | 1 | 0 | 1 | 1 | 0 | 0 | 0 | 0 | 1 | 1 | 0 | 223 => '30',
CONTROL | 1: R/NM | SEX | E0 | N → X | E | 0 | N | N |  | 0 | 0 | 0 | 0 | 0 | 1 | 1 | 1 | 0 | 0 | 0 | 0 | 1 | 1 | 0 | 224 => '30',
CONTROL | 1: R/NM | SEX | E1 | N → X | E | 1 | N | N |  | 1 | 0 | 0 | 0 | 0 | 1 | 1 | 1 | 0 | 0 | 0 | 0 | 1 | 1 | 0 | 225 => '30',
CONTROL | 1: R/NM | SEX | E2 | N → X | E | 2 | N | N |  | 0 | 1 | 0 | 0 | 0 | 1 | 1 | 1 | 0 | 0 | 0 | 0 | 1 | 1 | 0 | 226 => '30',
CONTROL | 1: R/NM | SEX | E3 | N → X | E | 3 | N | N |  | 1 | 1 | 0 | 0 | 0 | 1 | 1 | 1 | 0 | 0 | 0 | 0 | 1 | 1 | 0 | 227 => '30',
CONTROL | 1: R/NM | SEX | E4 | N → X | E | 4 | N | N |  | 0 | 0 | 1 | 0 | 0 | 1 | 1 | 1 | 0 | 0 | 0 | 0 | 1 | 1 | 0 | 228 => '30',
CONTROL | 1: R/NM | SEX | E5 | N → X | E | 5 | N | N |  | 1 | 0 | 1 | 0 | 0 | 1 | 1 | 1 | 0 | 0 | 0 | 0 | 1 | 1 | 0 | 229 => '30',
CONTROL | 1: R/NM | SEX | E6 | N → X | E | 6 | N | N |  | 0 | 1 | 1 | 0 | 0 | 1 | 1 | 1 | 0 | 0 | 0 | 0 | 1 | 1 | 0 | 230 => '30',
CONTROL | 1: R/NM | SEX | E7 | N → X | E | 7 | N | N |  | 1 | 1 | 1 | 0 | 0 | 1 | 1 | 1 | 0 | 0 | 0 | 0 | 1 | 1 | 0 | 231 => '30',
CONTROL | 1: R/NM | SEX | E8 | N → X | E | 8 | N | N |  | 0 | 0 | 0 | 1 | 0 | 1 | 1 | 1 | 0 | 0 | 0 | 0 | 1 | 1 | 0 | 232 => '30',
CONTROL | 1: R/NM | SEX | E9 | N → X | E | 9 | N | N |  | 1 | 0 | 0 | 1 | 0 | 1 | 1 | 1 | 0 | 0 | 0 | 0 | 1 | 1 | 0 | 233 => '30',
CONTROL | 1: R/NM | SEX | EA | N → X | E | A | N | N |  | 0 | 1 | 0 | 1 | 0 | 1 | 1 | 1 | 0 | 0 | 0 | 0 | 1 | 1 | 0 | 234 => '30',
CONTROL | 1: R/NM | SEX | EB | N → X | E | B | N | N |  | 1 | 1 | 0 | 1 | 0 | 1 | 1 | 1 | 0 | 0 | 0 | 0 | 1 | 1 | 0 | 235 => '30',
CONTROL | 1: R/NM | SEX | EC | N → X | E | C | N | N |  | 0 | 0 | 1 | 1 | 0 | 1 | 1 | 1 | 0 | 0 | 0 | 0 | 1 | 1 | 0 | 236 => '30',
CONTROL | 1: R/NM | SEX | ED | N → X | E | D | N | N |  | 1 | 0 | 1 | 1 | 0 | 1 | 1 | 1 | 0 | 0 | 0 | 0 | 1 | 1 | 0 | 237 => '30',
CONTROL | 1: R/NM | SEX | EE | N → X | E | E | N | N |  | 0 | 1 | 1 | 1 | 0 | 1 | 1 | 1 | 0 | 0 | 0 | 0 | 1 | 1 | 0 | 238 => '30',
CONTROL | 1: R/NM | SEX | EF | N → X | E | F | N | N |  | 1 | 1 | 1 | 1 | 0 | 1 | 1 | 1 | 0 | 0 | 0 | 0 | 1 | 1 | 0 | 239 => '30',
CONTROL | 1: R/NM | SEQ | 7B | 1 → Q | 7 | B | N | N |  | 1 | 1 | 0 | 1 | 1 | 1 | 1 | 0 | 0 | 0 | 0 | 0 | 1 | 1 | 0 | 123 => '30',
CONTROL | 1: R/NM | REQ | 7A | 0 → Q | 7 | A | N | N |  | 0 | 1 | 0 | 1 | 1 | 1 | 1 | 0 | 0 | 0 | 0 | 0 | 1 | 1 | 0 | 122 => '30',
CONTROL | 2: R/W | SAV | 78 | T → M(R(X)) | 7 | 8 | Y | Y | X | 0 | 0 | 0 | 1 | 1 | 1 | 1 | 0 | 0 | 0 | 0 | 0 | 1 | 0 | 1 | 120 => '50',
CONTROL | 2: R/W | MARK | 79 | (X, P)→ T; (X, P)→ M(R(2)), THEN P→ X; R(2) - 1→ R(2) | 7 | 9 | N | Y | 2 | 1 | 0 | 0 | 1 | 1 | 1 | 1 | 0 | 0 | 1 | 0 | 0 | 0 | 1 | 1 | 121 => '62',
CONTROL | 3: R/R | RET | 70 | M(R(X)) → (X, P); R(X) + 1 → R(X), 1 → lE | 7 | 0 | Y | Y | X | 0 | 0 | 0 | 0 | 1 | 1 | 1 | 0 | 0 | 0 | 0 | 0 | 1 | 0 | 1 | 112 => '50',
CONTROL | 3: R/R | DIS | 71 | M(R(X)) → (X, P); R(X) + 1 → R(X), 0 → lE | 7 | 1 | Y | Y | X | 1 | 0 | 0 | 0 | 1 | 1 | 1 | 0 | 0 | 0 | 0 | 0 | 1 | 0 | 1 | 113 => '50',
INPUT - OUTPUT | 3: R/R | OUT1 | 61 | M(R(X)) → BUS; R(X) + 1 → R(X); N LINES = 1 | 6 | 1 | Y | Y | X | 1 | 0 | 0 | 0 | 0 | 1 | 1 | 0 | 0 | 0 | 0 | 0 | 1 | 0 | 1 | 97 => '50',
INPUT - OUTPUT | 3: R/R | OUT2 | 62 | M(R(X)) → BUS; R(X) + 1 → R(X); N LINES = 2 | 6 | 2 | Y | Y | X | 0 | 1 | 0 | 0 | 0 | 1 | 1 | 0 | 0 | 0 | 0 | 0 | 1 | 0 | 1 | 98 => '50',
INPUT - OUTPUT | 3: R/R | OUT3 | 63 | M(R(X)) → BUS; R(X) + 1 → R(X); N LINES = 3 | 6 | 3 | Y | Y | X | 1 | 1 | 0 | 0 | 0 | 1 | 1 | 0 | 0 | 0 | 0 | 0 | 1 | 0 | 1 | 99 => '50',
INPUT - OUTPUT | 3: R/R | OUT4 | 64 | M(R(X)) → BUS; R(X) + 1 → R(X); N LINES = 4 | 6 | 4 | Y | Y | X | 0 | 0 | 1 | 0 | 0 | 1 | 1 | 0 | 0 | 0 | 0 | 0 | 1 | 0 | 1 | 100 => '50',
INPUT - OUTPUT | 3: R/R | OUT5 | 65 | M(R(X)) → BUS; R(X) + 1 → R(X); N LINES = 5 | 6 | 5 | Y | Y | X | 1 | 0 | 1 | 0 | 0 | 1 | 1 | 0 | 0 | 0 | 0 | 0 | 1 | 0 | 1 | 101 => '50',
INPUT - OUTPUT | 3: R/R | OUT6 | 66 | M(R(X)) → BUS; R(X) + 1 → R(X); N LINES = 6 | 6 | 6 | Y | Y | X | 0 | 1 | 1 | 0 | 0 | 1 | 1 | 0 | 0 | 0 | 0 | 0 | 1 | 0 | 1 | 102 => '50',
INPUT - OUTPUT | 3: R/R | OUT7 | 67 | M(R(X)) → BUS; R(X) + 1 → R(X); N LINES = 7 | 6 | 7 | Y | Y | X | 1 | 1 | 1 | 0 | 0 | 1 | 1 | 0 | 0 | 0 | 0 | 0 | 1 | 0 | 1 | 103 => '50',
INPUT - OUTPUT | 2: R/W | INP1 | 69 | BUS → M(R(X)); BUS → D; N LINES = 1 | 6 | 9 | Y | Y | X | 1 | 0 | 0 | 1 | 0 | 1 | 1 | 0 | 0 | 0 | 0 | 0 | 1 | 0 | 1 | 105 => '50',
INPUT - OUTPUT | 2: R/W | INP2 | 6A | BUS → M(R(X)); BUS → D; N LINES = 2 | 6 | A | Y | Y | X | 0 | 1 | 0 | 1 | 0 | 1 | 1 | 0 | 0 | 0 | 0 | 0 | 1 | 0 | 1 | 106 => '50',
INPUT - OUTPUT | 2: R/W | INP3 | 6B | BUS → M(R(X)); BUS → D; N LINES = 3 | 6 | B | Y | Y | X | 1 | 1 | 0 | 1 | 0 | 1 | 1 | 0 | 0 | 0 | 0 | 0 | 1 | 0 | 1 | 107 => '50',
INPUT - OUTPUT | 2: R/W | INP4 | 6C | BUS → M(R(X)); BUS → D; N LINES = 4 | 6 | C | Y | Y | X | 0 | 0 | 1 | 1 | 0 | 1 | 1 | 0 | 0 | 0 | 0 | 0 | 1 | 0 | 1 | 108 => '50',
INPUT - OUTPUT | 2: R/W | INP5 | 6D | BUS → M(R(X)); BUS → D; N LINES = 5 | 6 | D | Y | Y | X | 1 | 0 | 1 | 1 | 0 | 1 | 1 | 0 | 0 | 0 | 0 | 0 | 1 | 0 | 1 | 109 => '50',
INPUT - OUTPUT | 2: R/W | INP6 | 6E | BUS → M(R(X)); BUS → D; N LINES = 6 | 6 | E | Y | Y | X | 0 | 1 | 1 | 1 | 0 | 1 | 1 | 0 | 0 | 0 | 0 | 0 | 1 | 0 | 1 | 110 => '50',
INPUT - OUTPUT | 2: R/W | INP7 | 6F | BUS → M(R(X)); BUS → D; N LINES = 7 | 6 | F | Y | Y | X | 1 | 1 | 1 | 1 | 0 | 1 | 1 | 0 | 0 | 0 | 0 | 0 | 1 | 0 | 1 | 111 => '50',
