jeff-truck/Jan2023-Build/Schematics/Schematic_2023 JAN CPU V1_2023-02-20.pdf

## 4MHz CLOCK

CLK-P 25 +12V 26 F4 27 61-N 28 WIN-N 29 F1 30 F5 31 A17 32 A16 33 GND 34 A7 35 A6 36 A5 37 A4 38 A3 39 A2 40 A1 41 A0 42 D7 43 D6 44 D5 45 D4 46 D3 47 D2 48 D1 49 D0 50

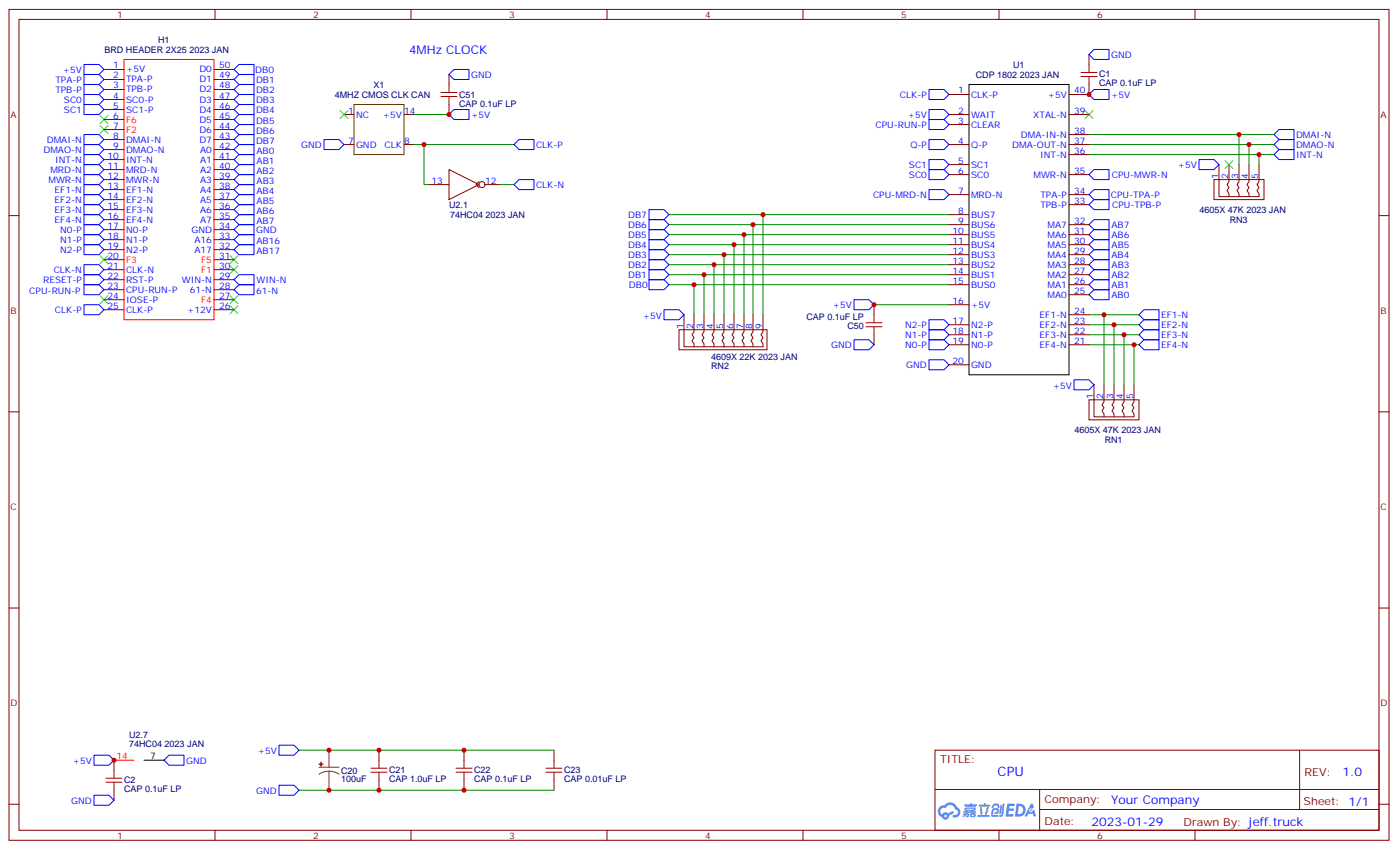
[picture p20: page 1]

Drawn By: jeff.truck

Nano Interface Device | Address Bus Interface | Data Bus Interface

## Nano

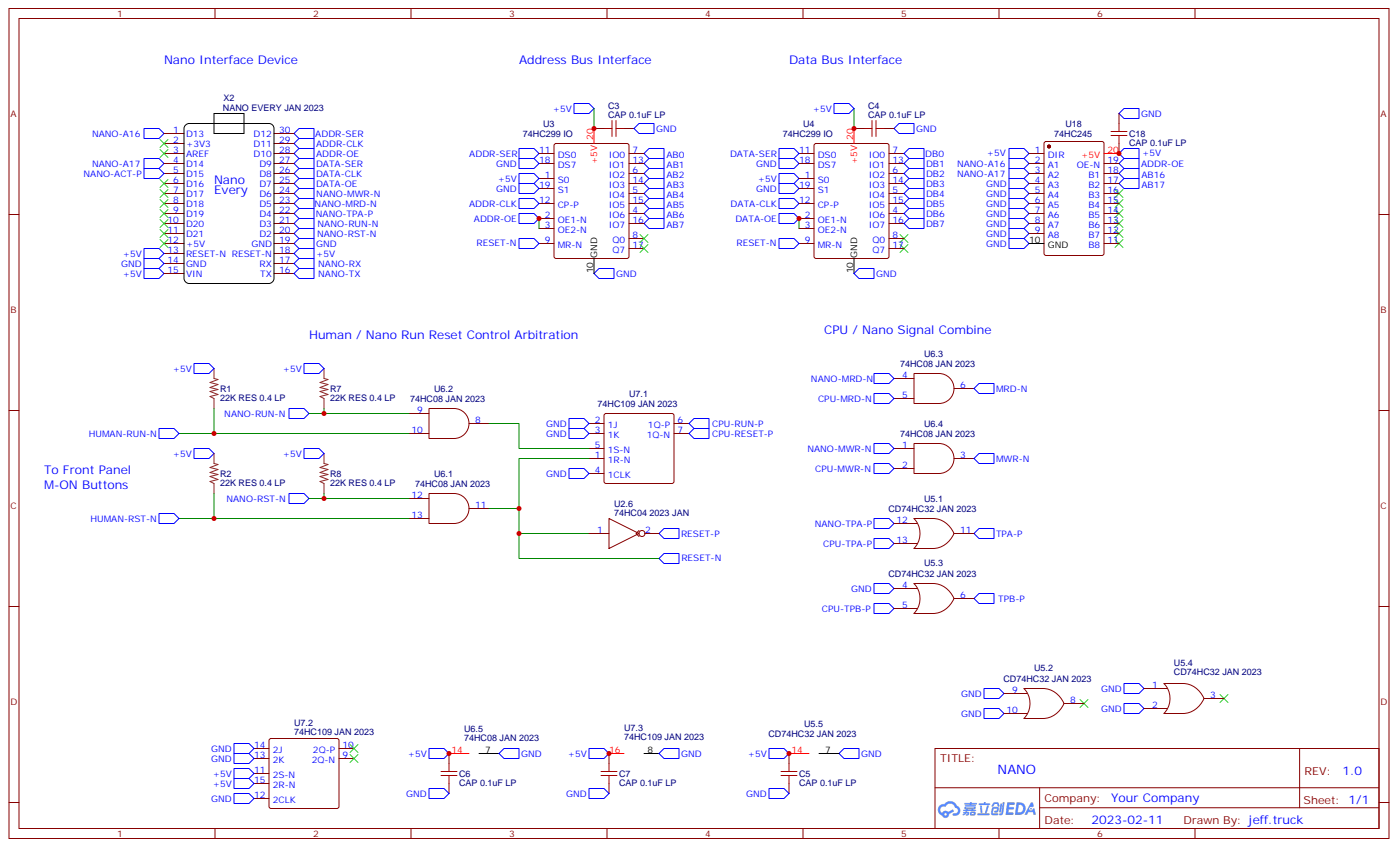
[picture p21: page 2]

## Q Speaker

## Speaker

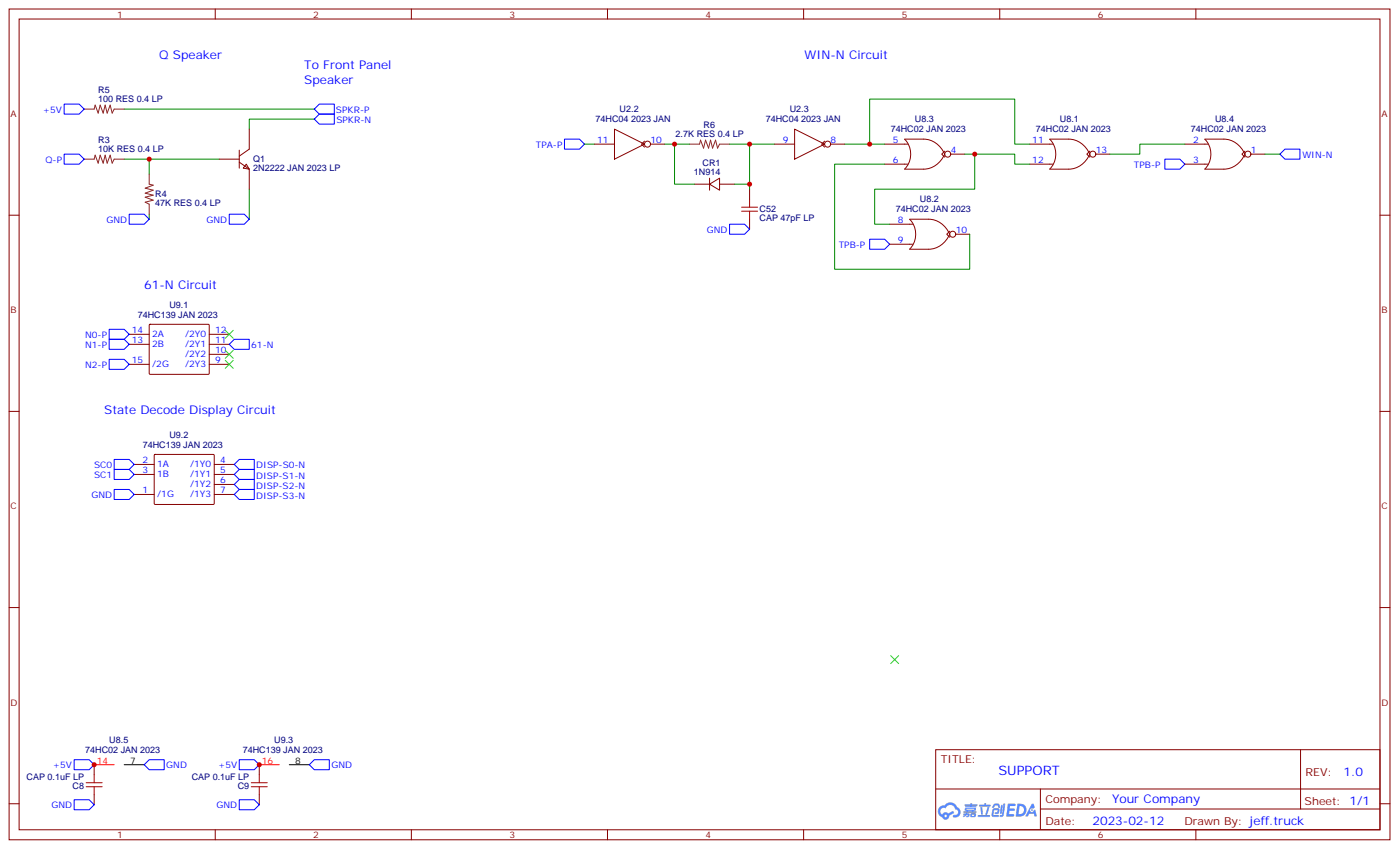
[picture p22: page 3]

State Decode Display Circuit

## IO 2 LEVEL GROUP SELECT

## IO COMMAND DECODE

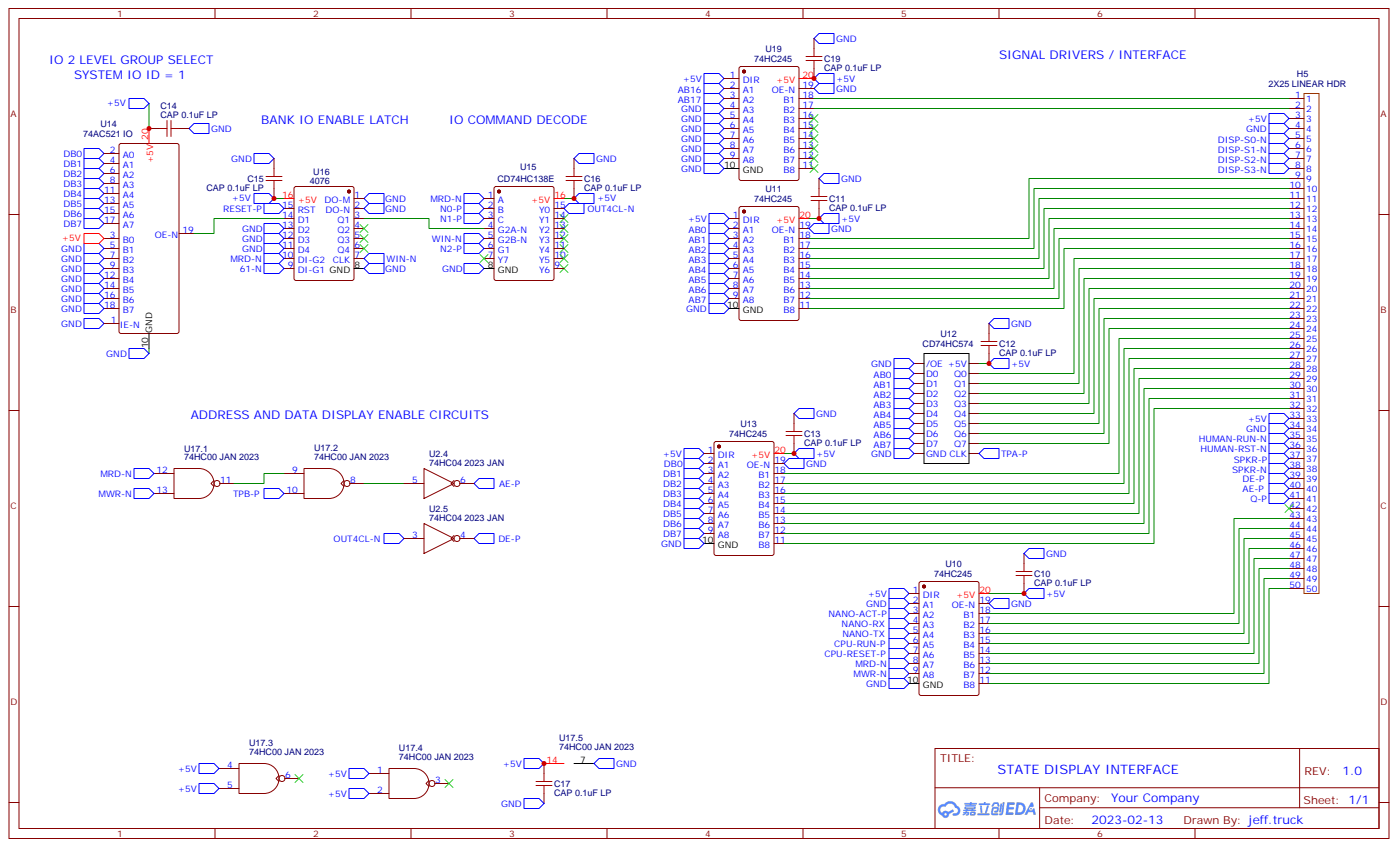
[picture p23: page 4]

BANK IO ENABLE LATCH

ADDRESS AND DATA DISPLAY ENABLE CIRCUITS
