jeff-truck/Jan2023-Build/Schematics/Schematic_2023 JAN DISPLAY LOGIC_2023-04-11.pdf

## Display Multiplexing - Clock

## Display Multiplexing - CC and Latch Logic


Signal Interface - CPU Board

Display Multiplexing - EEPROM Latches

Display State Machine EEPROM

Signal Interface - UART Board

Drawn By: jeff.truck
