jeff-truck/Jan2023-Build/Schematics/Schematic_2023 JAN FDC_2023-05-05.pdf

## IO 2 LEVEL SELECT / IO DECODES

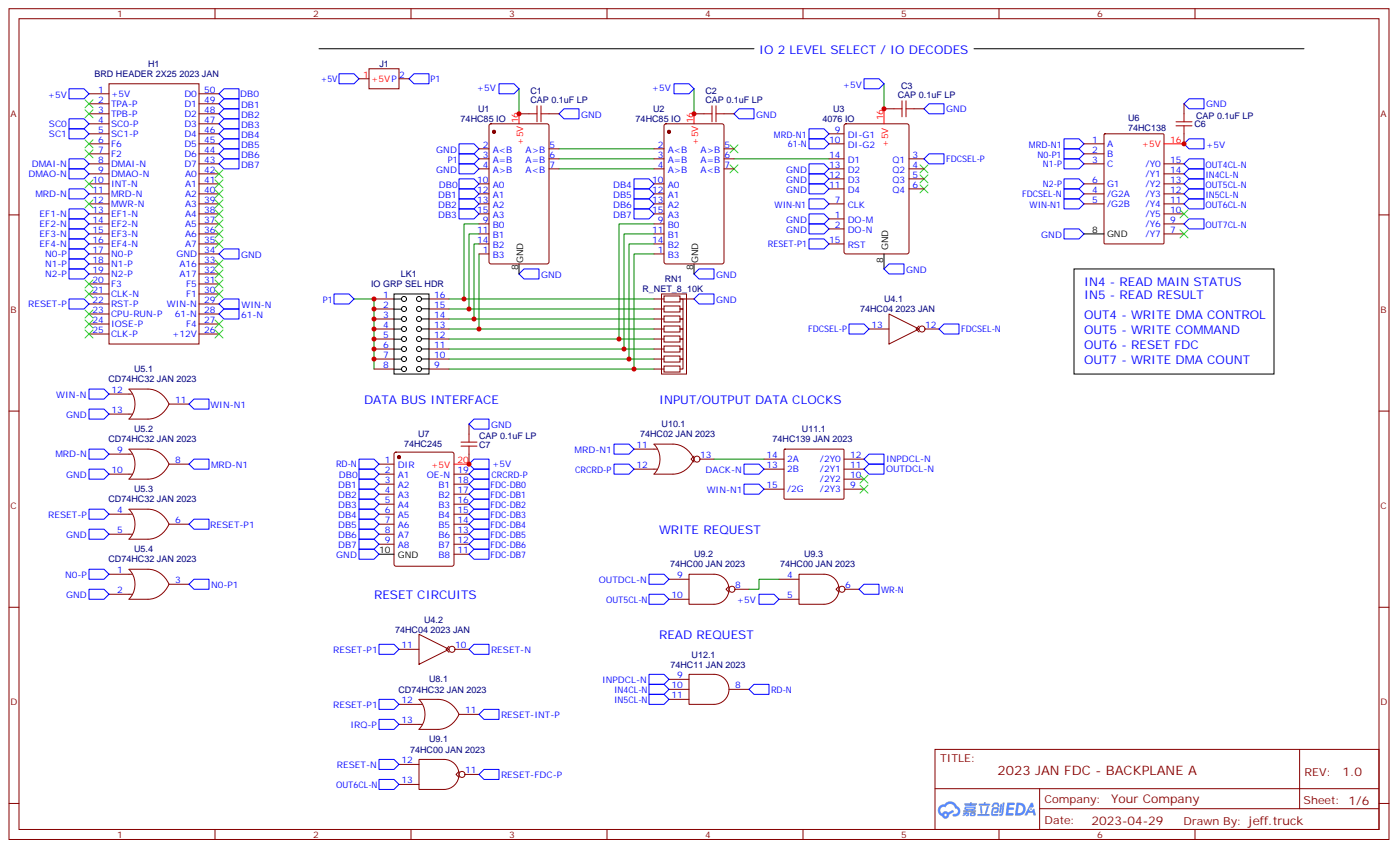
[picture p25: page 1]

INPUT/OUTPUT DATA CLOCKS

Drawn By: jeff.truck

## SET DMA DIRECTION

## DMA INTERFACE CIRCUIT

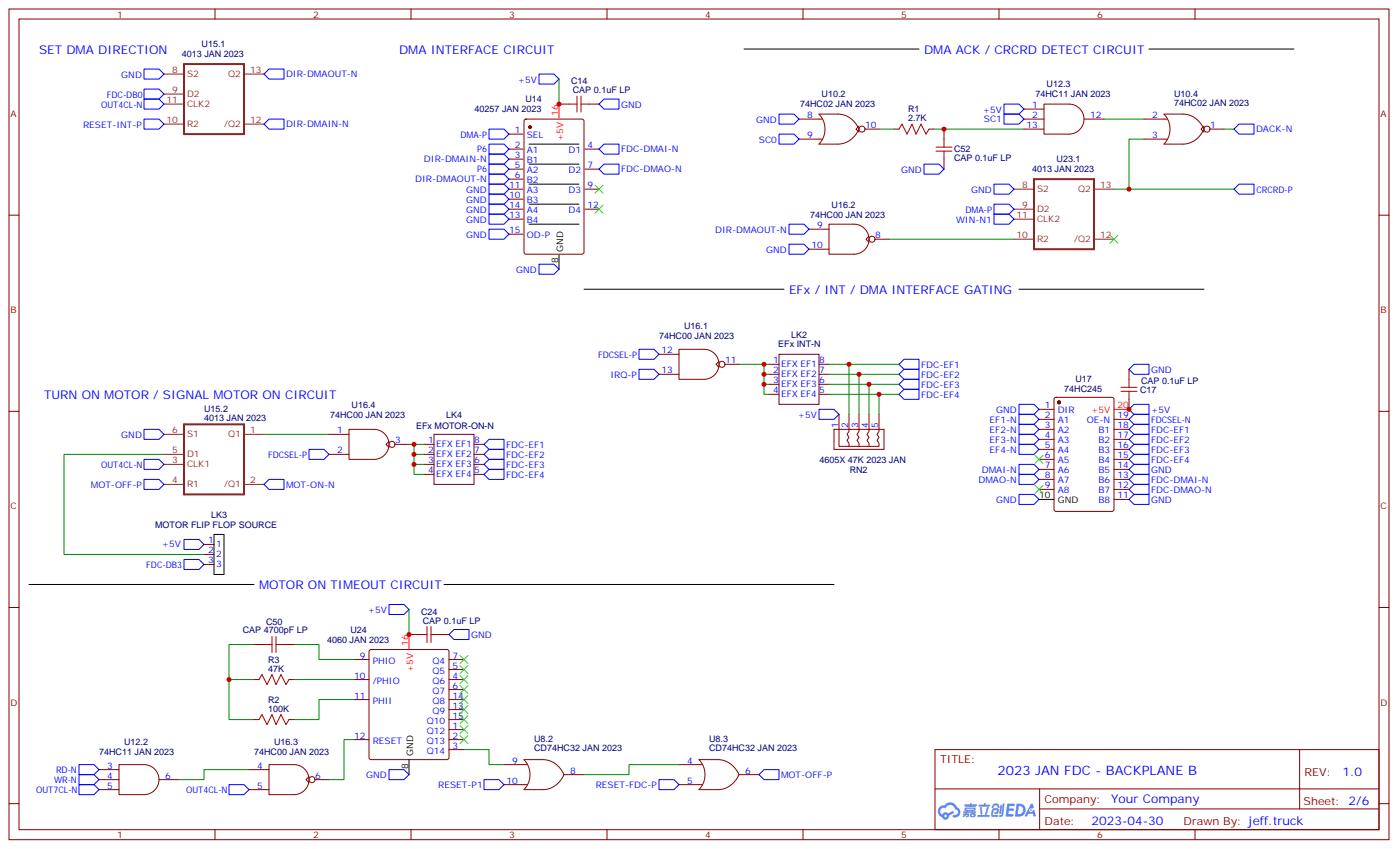
[picture p26: page 2]

DMA ACK / CRCRD DETECT CIRCUIT

EFx / INT / DMA INTERFACE GATING

TURN ON MOTOR / SIGNAL MOTOR ON CIRCUIT

## TERMINAL COUNT CIRCUIT

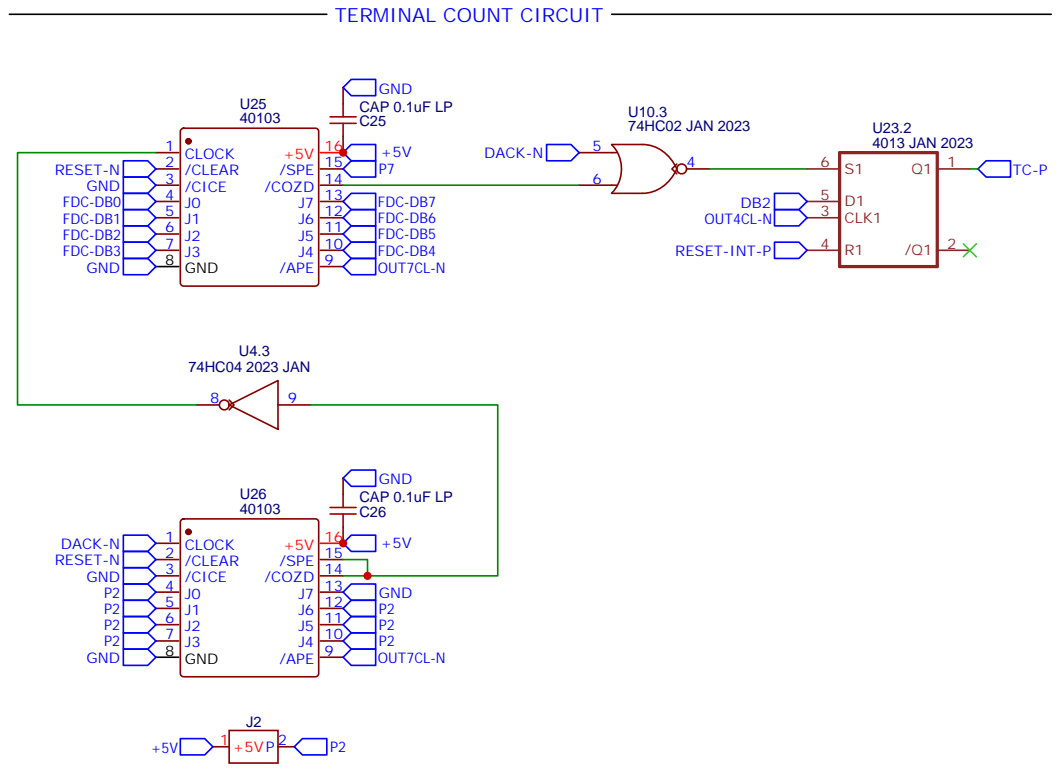
[picture p27: page 3]

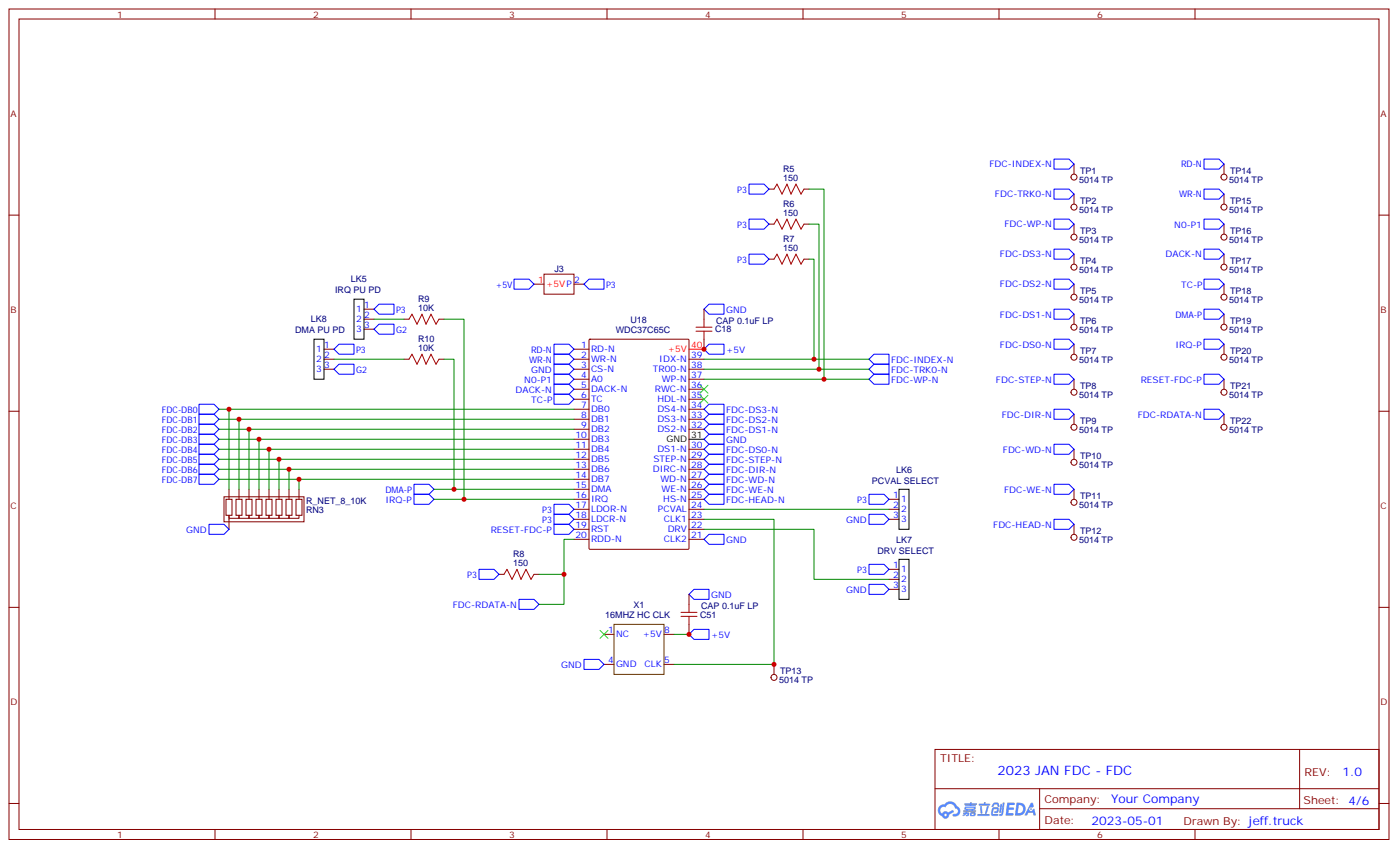
[picture p28: page 4]

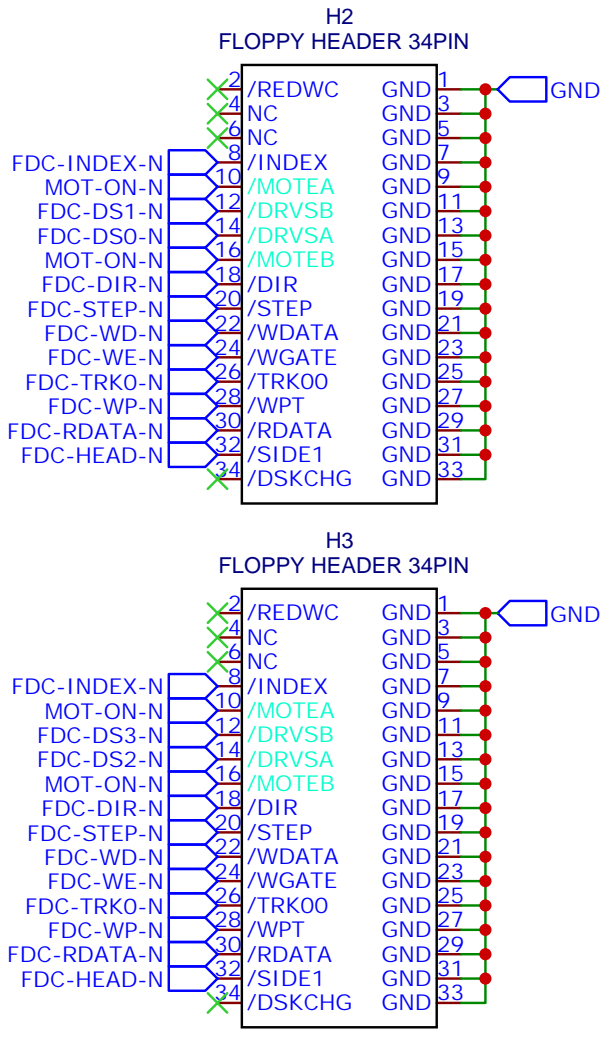
[picture p29: page 5]

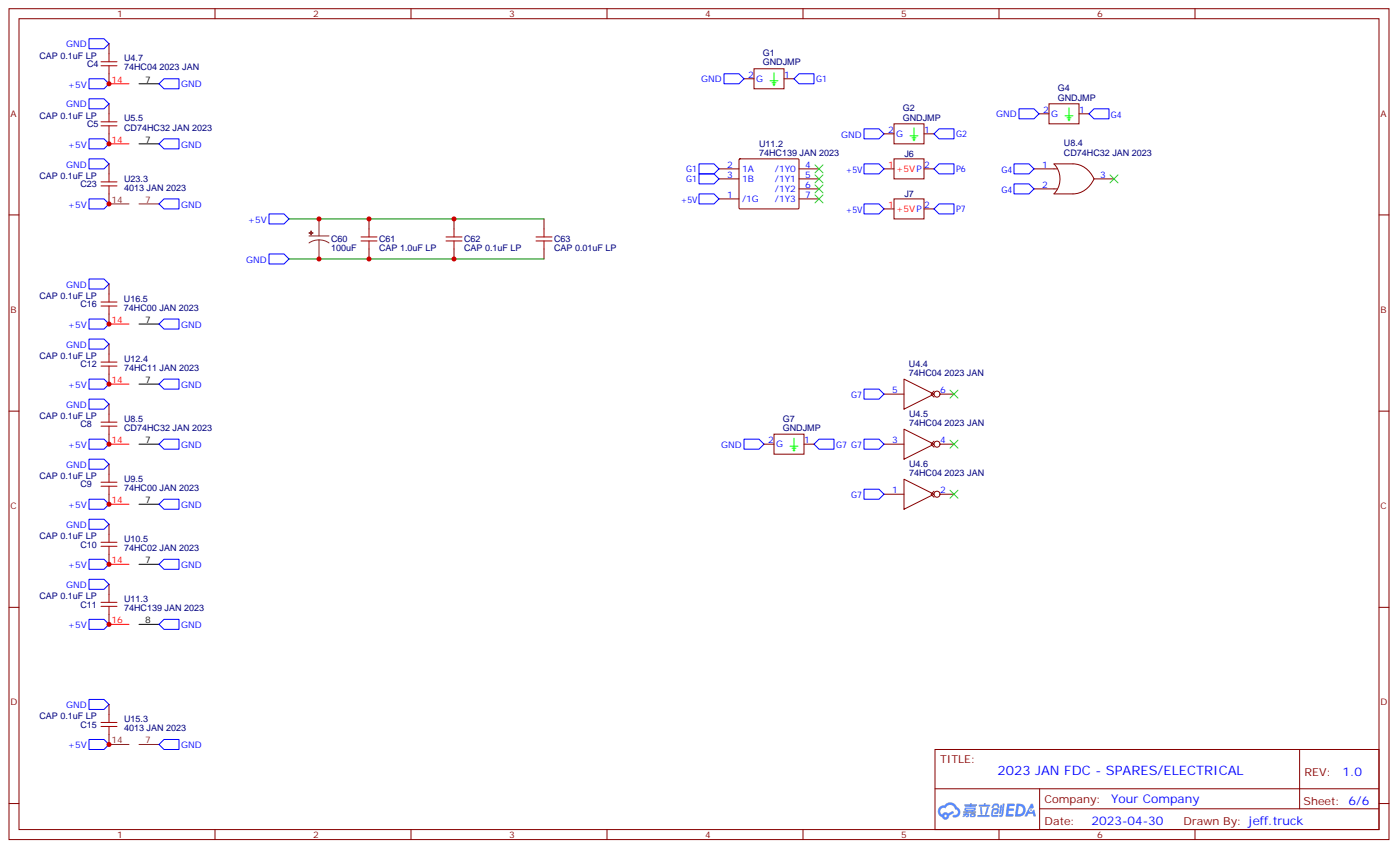
[picture p30: page 6]
