jeff-truck/Jan2023-Build/Schematics/Schematic_2023 JAN MMU_2023-02-27.pdf

## LOGIC BUFFERS

CLK-P 25 +12V 26 F4 27 61-N 28 WIN-N 29 F1 30 F5 31 A17 32 A16 33 GND 34 A7 35 A6 36 A5 37 A4 38 A3 39 A2 40 A1 41 A0 42 D7 43 D6 44 D5 45 D4 46 D3 47 D2 48 D1 49 D0 50

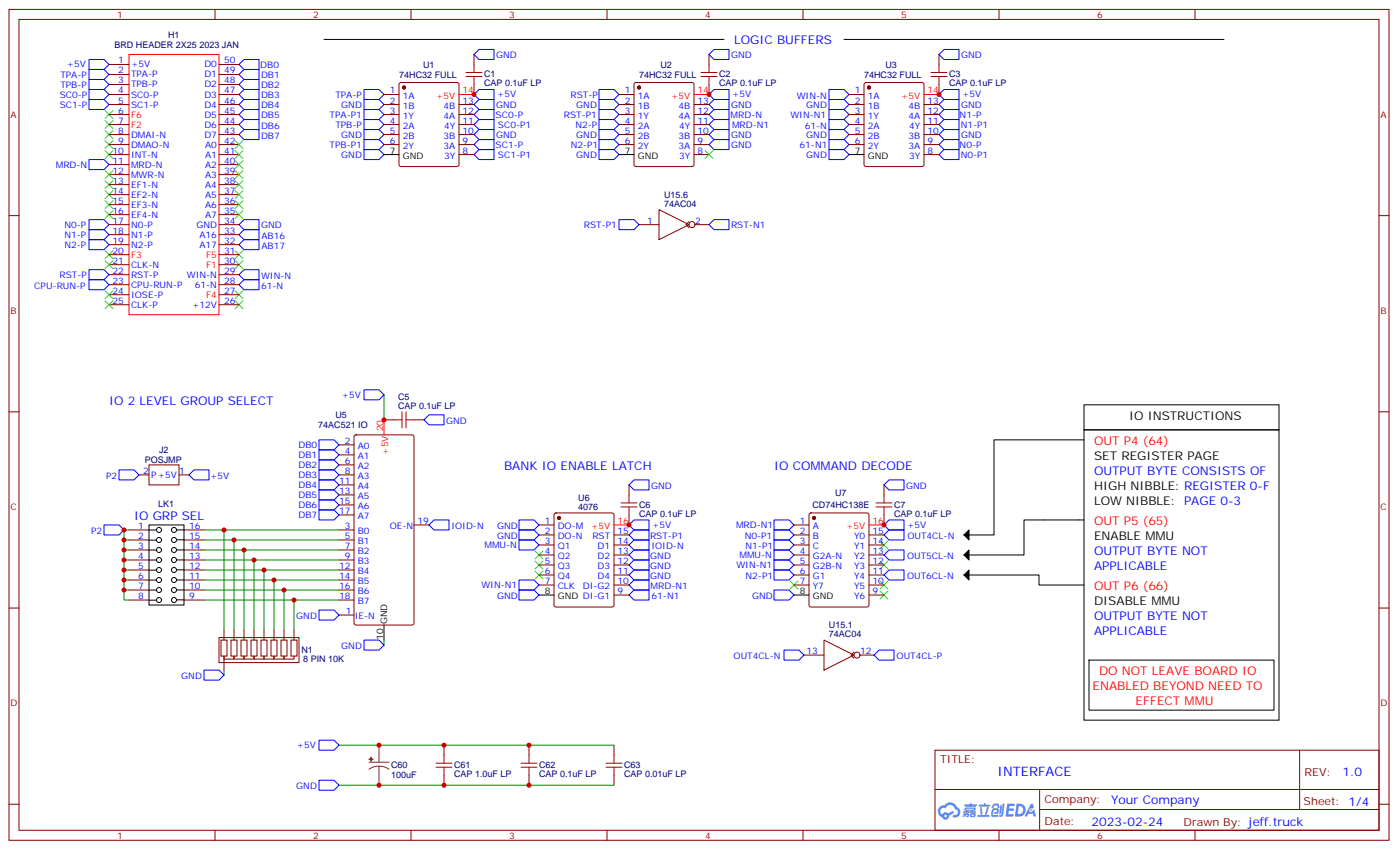
[picture p31: page 1]

+5V IO 2 LEVEL GROUP SELECT

IO INSTRUCTIONS
OUT P4 (64)
SET REGISTER PAGE
OUTPUT BYTE CONSISTS OF
HIGH NIBBLE:
LOW NIBBLE:
OUT P5 (65)
ENABLE MMU
OUTPUT BYTE NOT
APPLICABLE
OUT P6 (66)
DISABLE MMU

BANK IO ENABLE LATCH

DO NOT LEAVE BOARD IO
ENABLED BEYOND NEED TO
EFFECT MMU

Drawn By: jeff.truck

## CHOSEN FOR 4MHz CPU CLOCK

## NOTE: R1,R2,C50,C51

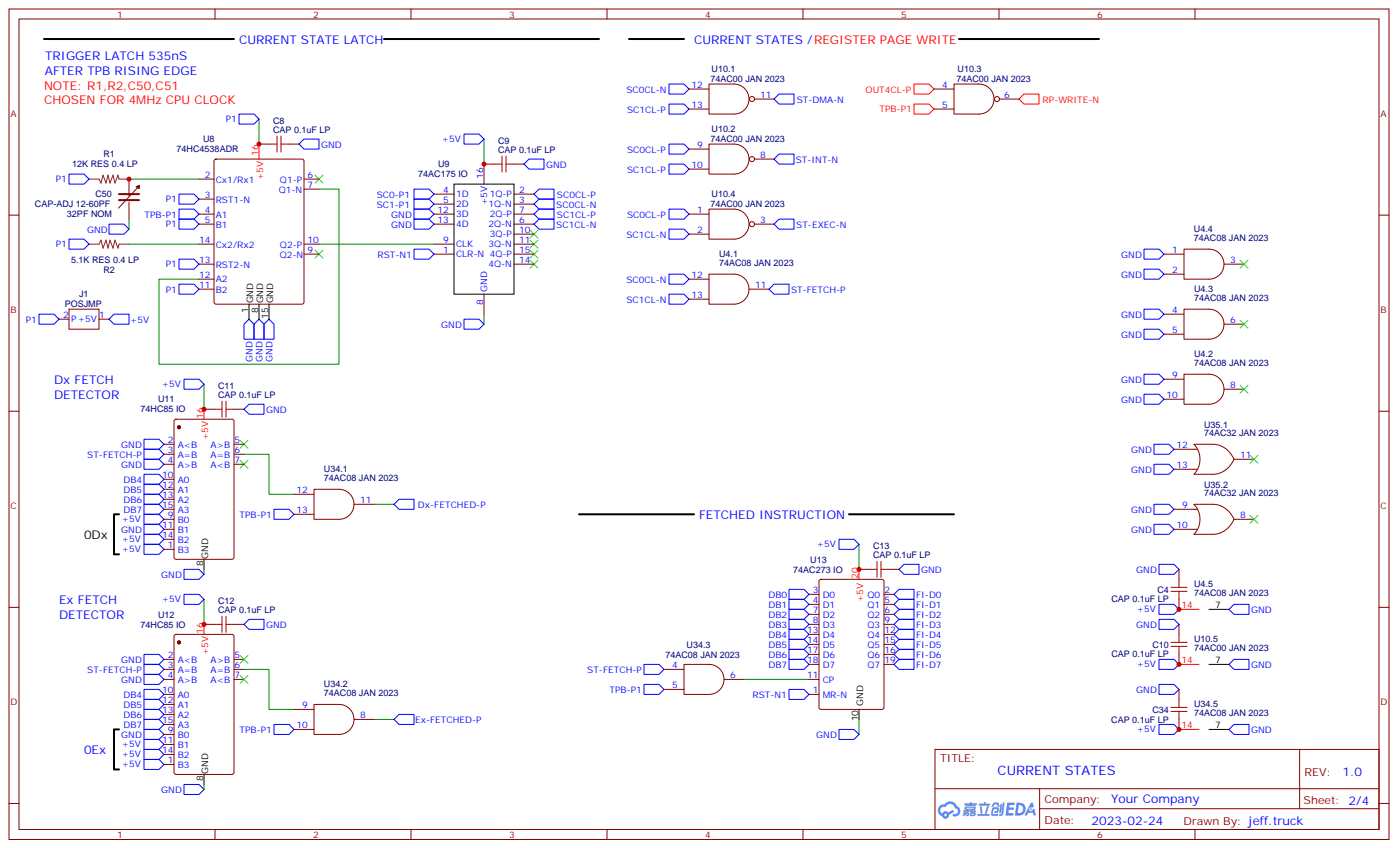
[picture p32: page 2]

TRIGGER LATCH 535nS
AFTER TPB RISING EDGE

A | 6nS | 6nS | 6nS | A

12nS

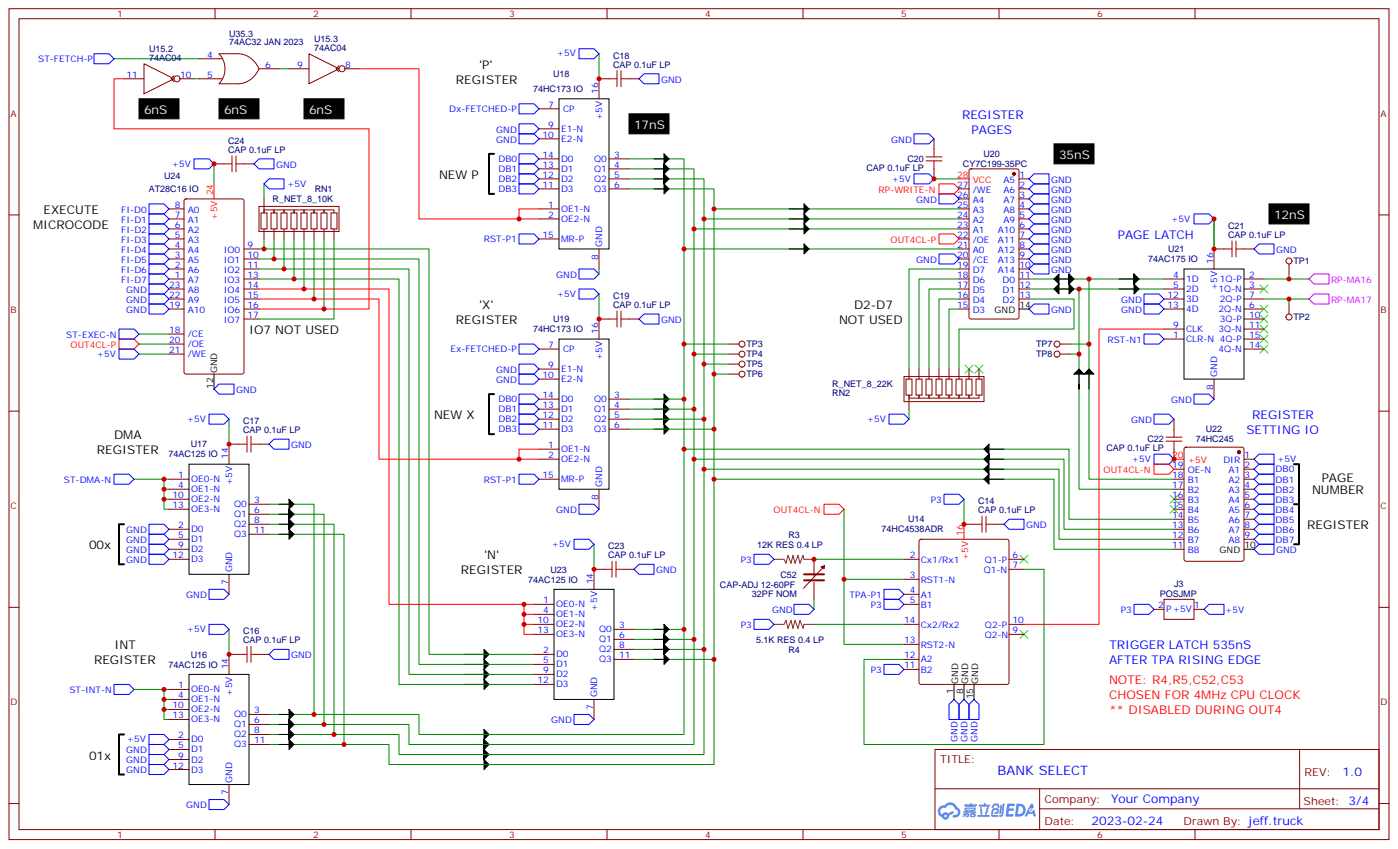
[picture p33: page 3]

TRIGGER LATCH 535nS
AFTER TPA RISING EDGE
NOTE: R4,R5,C52,C53
CHOSEN FOR 4MHz CPU CLOCK
** DISABLED DURING OUT4

## SYSTEM (ENABLE / DISABLE) OR NANO BANKING

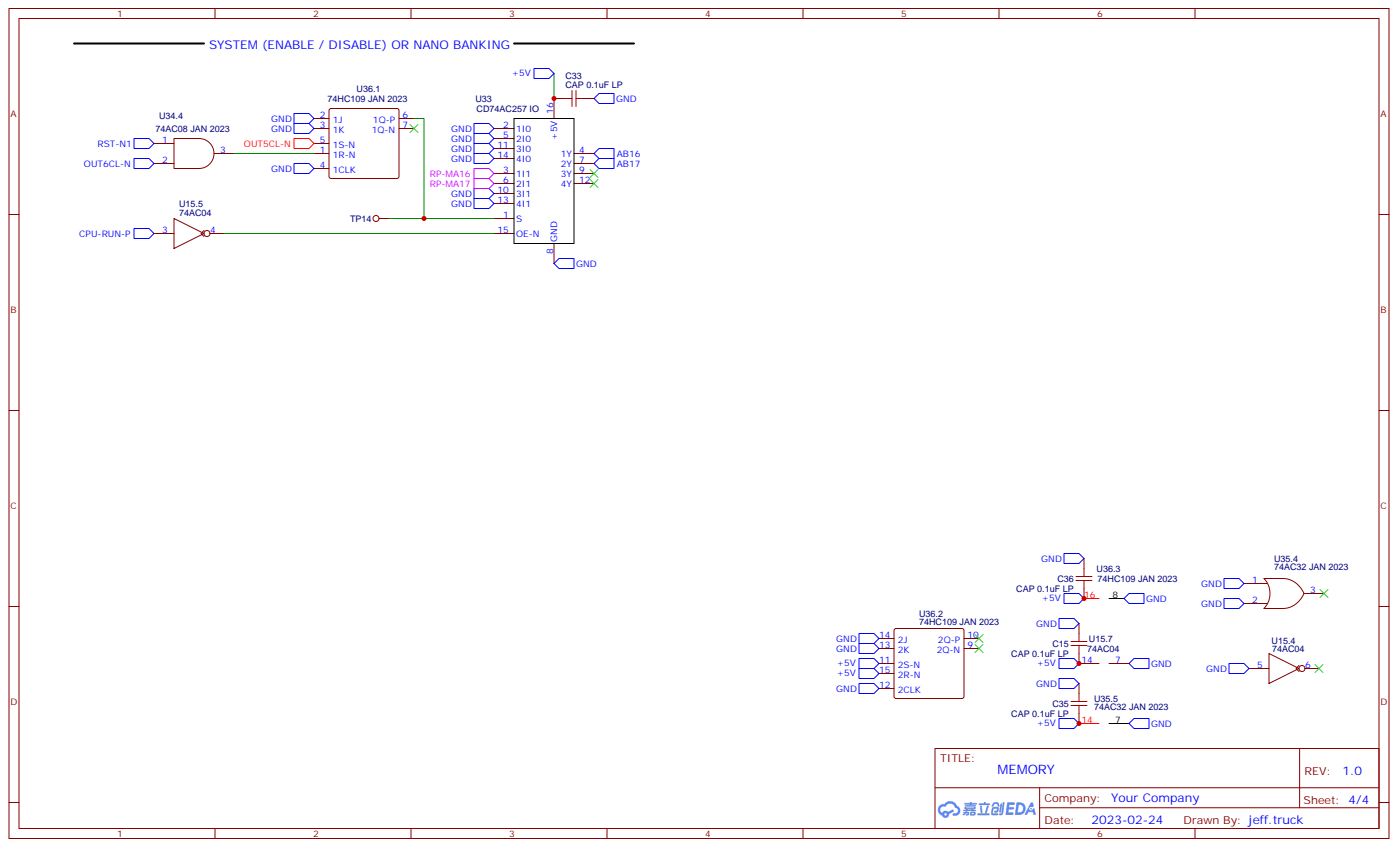
[picture p34: page 4]
