jeff-truck/Jan2023-Build/Schematics/Schematic_2023 JAN UART_2023-03-24.pdf

CLK-P 25 +12V 26 F4 27 61-N 28 WIN-N 29 F1 30 F5 31 A17 32 A16 33 GND 34 A7 35 A6 36 A5 37 A4 38 A3 39 A2 40 A1 41 A0 42 D7 43 D6 44 D5 45 D4 46 D3 47 D2 48 D1 49 D0 50

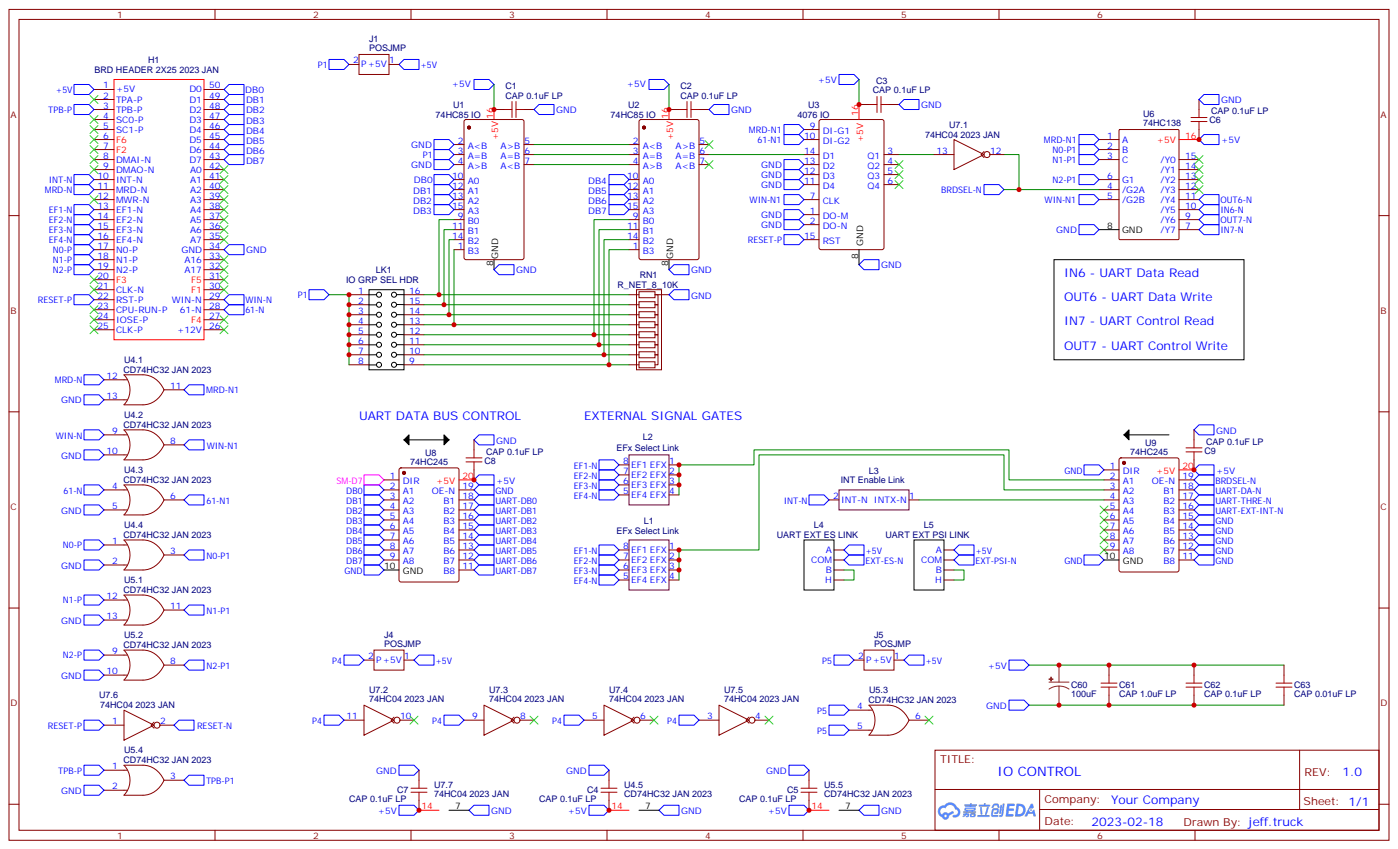
[picture p35: page 1]

UART DATA BUS CONTROL

UART EXT ES LINK

UART EXT PSI LINK

Drawn By: jeff.truck

1.8432 MHz = 115K/57K BAUD RATE CLOCK | STATE MACHINE

## CDP 1854 UART

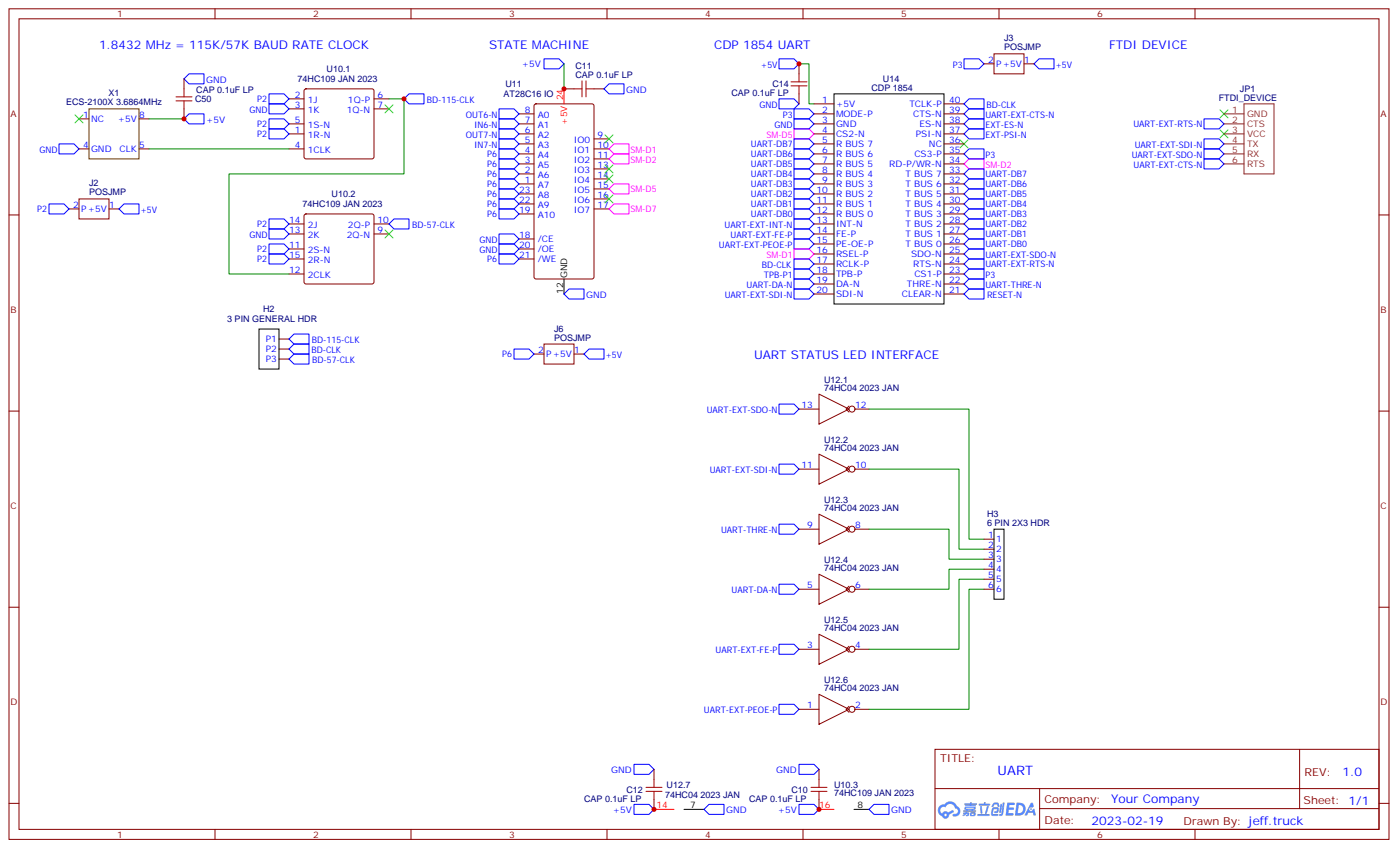
[picture p36: page 2]

UART STATUS LED INTERFACE

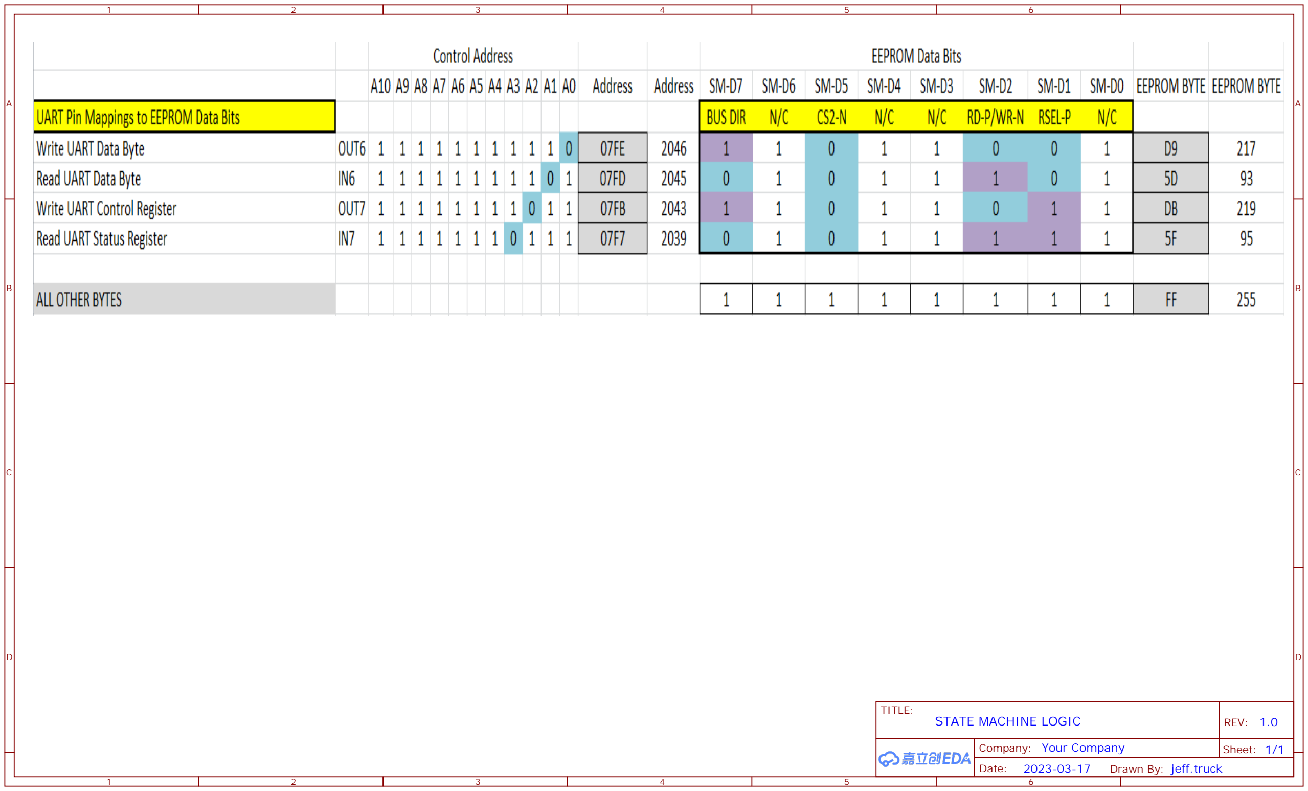
[picture p37: page 3]

A | A
B | B
C | C
D | D

### TITLE:

STATE MACHINE LOGIC | REV: 1.0
Date: | 2023-03-17
