jeff-truck/Jan2023-Build/Schematics/Schematic_2023 JAN DISPLAY BOARD_2023-03-24.pdf

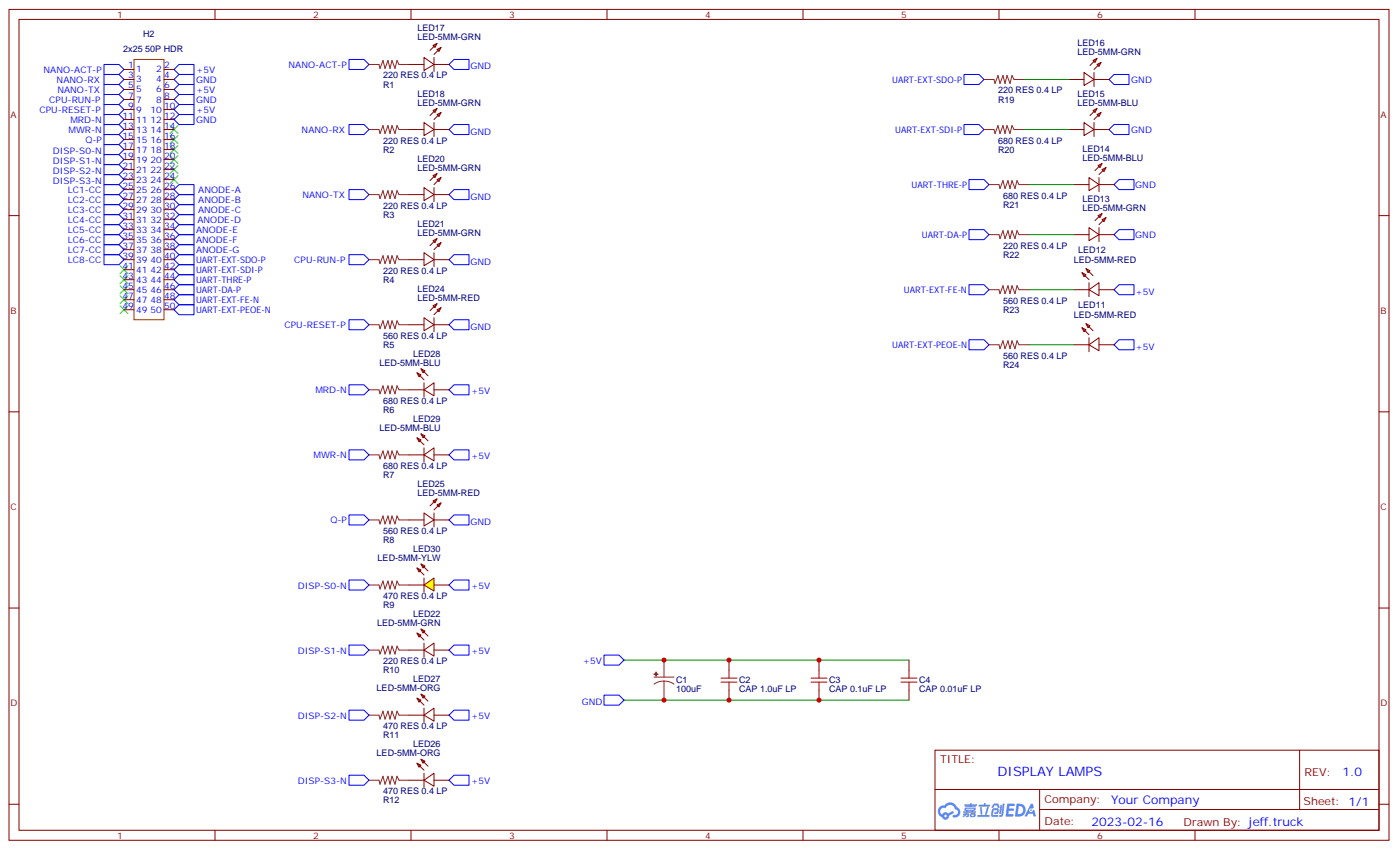
[picture p38: page 1]

Drawn By: jeff.truck

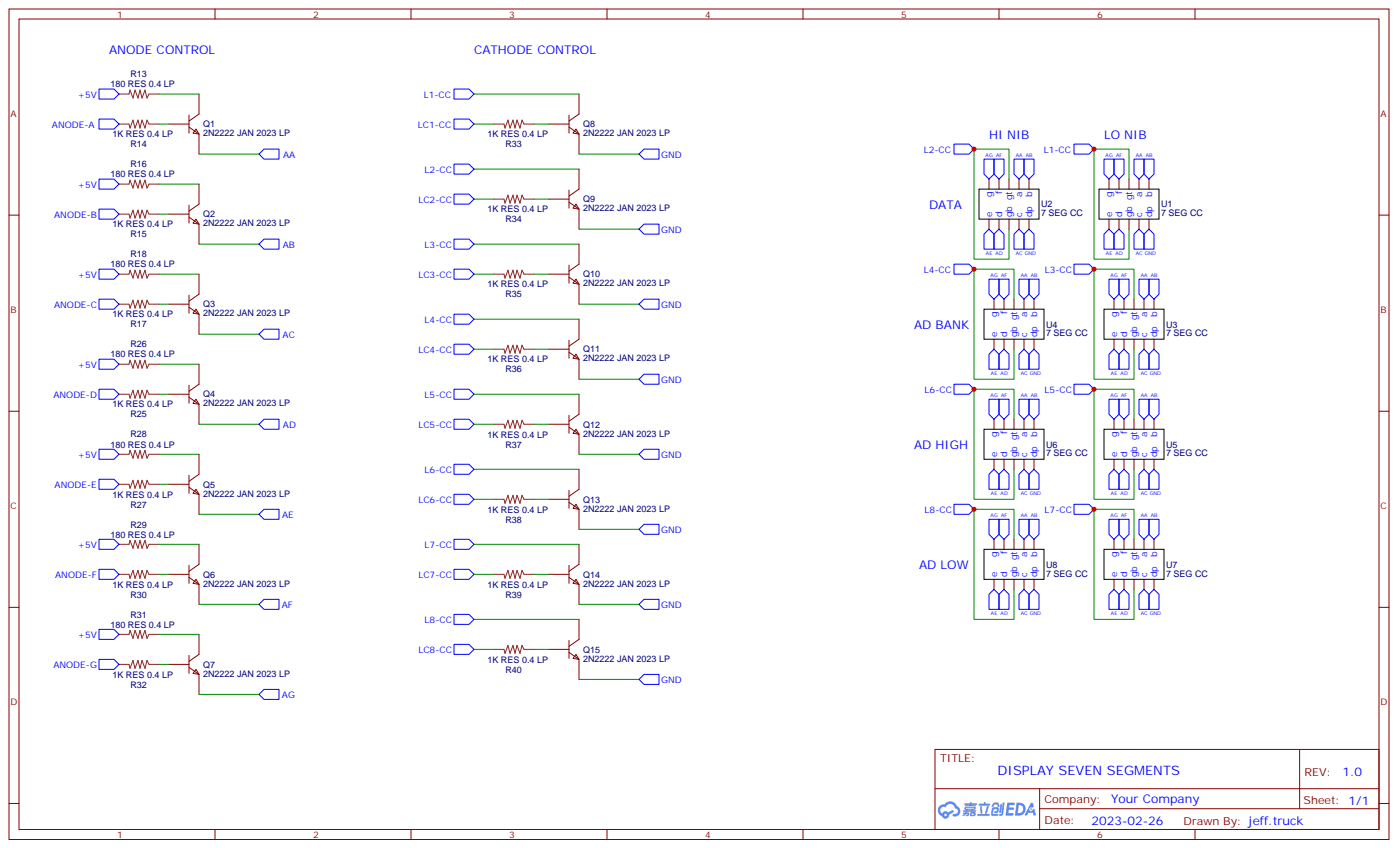
[picture p39: page 2]

Drawn By: jeff.truck
