jeff-truck/Jan2023-Build/Schematics/Schematic_2023 JAN MEMORY_2023-03-24.pdf

# Y5 10 Y4 11 Y3 12 Y2 13 Y1 14 Y0 15

## FETCH STATE

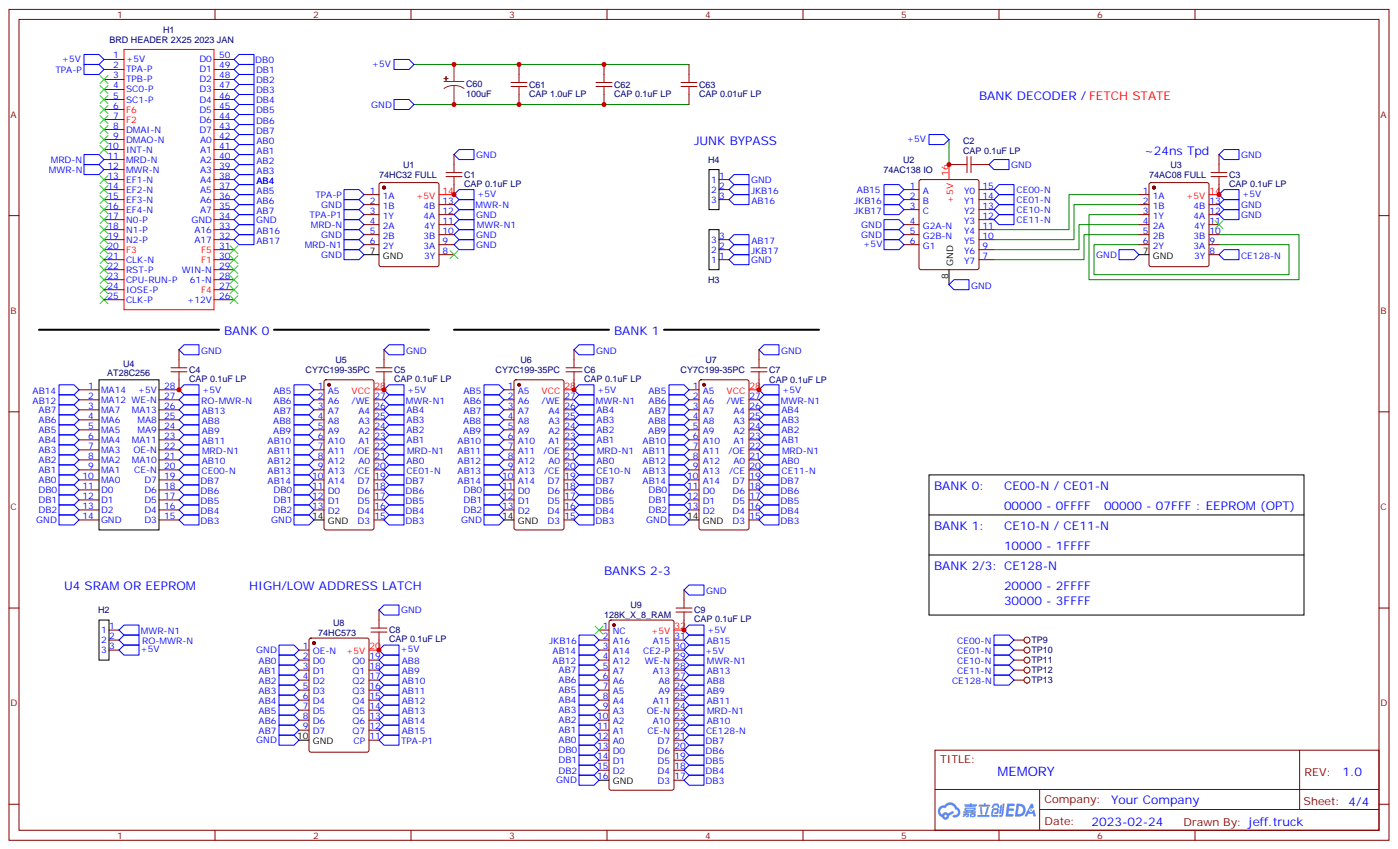
[picture p40: page 1]

HIGH/LOW ADDRESS LATCH

Drawn By: jeff.truck
