jeff-truck/Jan2023-Build/(commit log)

2023-07-09 Initial Version
    [1802 Instruction Set Microcode 20221230.xlsx, BOM_2023 JAN CPU V1_2023-03-24.csv, BOM_2023 JAN DISPLAY BOARD_2023-03-24.csv, BOM_2023 JAN DISPLAY LOGIC_2023-03-24.csv, BOM_2023 JAN FDC_2023-05-28.csv, BOM_2023 JAN MEMORY_2023-03-24.csv, BOM_2023 JAN MMU_2023-03-24.csv, BOM_2023 JAN UART_2023-03-24.csv]
2023-09-27 Create Jan2023_DisplayFrameMount_v2.rsdocx
    I designed and printed this object to allow the display board to be anchored to the front of the card cage.
2024-05-27 Added some missing files, the Arduino Nano Every code and the Desktop application which commands it.
    [Jan2013NanoLoader_v2.ino]
2024-12-27 Sync Point
    [1802 Instruction Set Microcode 20221230.xlsx]
